TransistorTun/Tuna_Pedal/Digital_Multi_Effect_Guitar_Pedal_Spec.docx

# Thiết kế Pedal ghita kĩ thuật số đa hiệu ứng

DIGITAL MULTI EFFECT GUITAR PEDAL

# 1. Yêu cầu hệ thống

## 1.1. Tên hệ thống

- Tiếng Việt: Pedal kĩ thuật số đa hiệu ứng.
- Tiếng Anh:Digital Multi Effect Pedal.

## 1.2. Mục đích

- Thu gọn nhiều bộ pedal Analog thành một bộ pedal Digital.
- Tạo ra nhiều hiệu ứng hơn cho các loại nhạc cụ điện tử.

## 1.3. Đầu vào – đầu ra

### 1.3.1. Đầu vào

- Tín hiệu analog được thu từ ghita điện hoặc piano điện,…
- 2 Nút nhấn.
- 3 Rotery Encoder.
- 2 Switch.

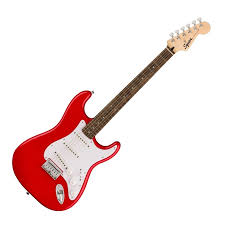
[picture p1: figure]
Đàn guitar điện Squier Sonic Stratocaster HT Torino Red

Hình 1-1.Nhạc cụ điện.

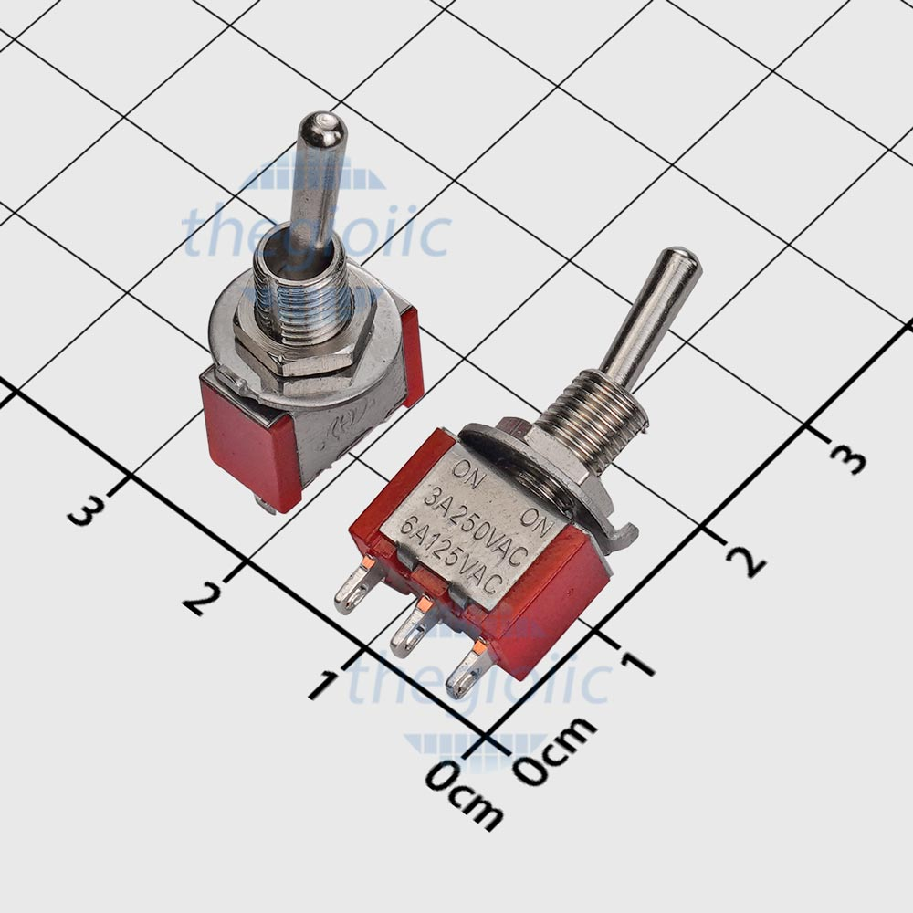
[picture p2: figure]

Hình 1-2. Switch gạt.

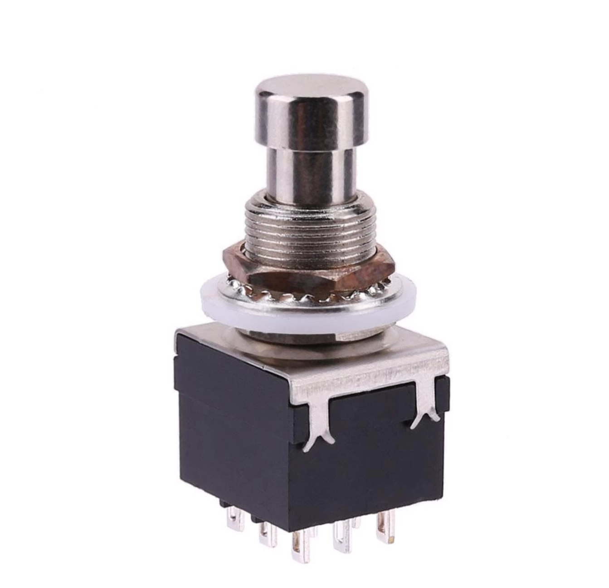
[picture p3: figure]

Hình 1-3. Nút nhấn đạp

### 1.3.2. Đầu ra

- Âm thanh đã được xử lý theo ý muốn.
- Màn hình giúp cho người sử dụng dễ dàng điều khiển và sử dụng.

## 1.4. Trường hợp sử dụng

- Sử dụng để tạo ra những hiệu ứng âm thanh tùy thuộc vào thể loại âm nhạc mà người sử dụng nhạc cụ đang chơi, tạo ra them nhiều màu sắc hơn cho âm thanh.

## 1.5. Chức năng

- Biến đổi, điều chỉnh và lọc nhiễu âm thanh như ý muốn của người sử dụng.

## 1.6. Hiệu năng

- Lấy mẫu: Có thể lấy mẫu từ khoảng 48 – 96 kHz.
- Output: Đưa ra được âm thanh chất lượng cao.
- Hiệu ứng: Được ít nhất từ 5 -10 hiệu ứng, có thể điều chỉnh được các thông số trên hiệu ứng đó.

## 1.7. Nguồn cấp

- Nguồn cấp lấy từ adapter 12V 2A.

## 1.8. Lắp đặt

## 1.9. Chi phí sản xuất

- Chi phí dự kiến cho mạch đo:
- Chi phí dự kiến cho điện cực:

# 2. Lựa chọn linh kiện

## 2.1. Input

Đầu nối từ nhạc cụ tới board ta sử dụng: PJ-309 Cổng Audio 6.35mm 3 Cực 3 Chân Hàn PCB Loại Mono, Size: 35 x 18 x 11mm (https://www.thegioiic.com/pj-309-cong-audio-6-35mm-3-cuc-3-chan-han-pcb)

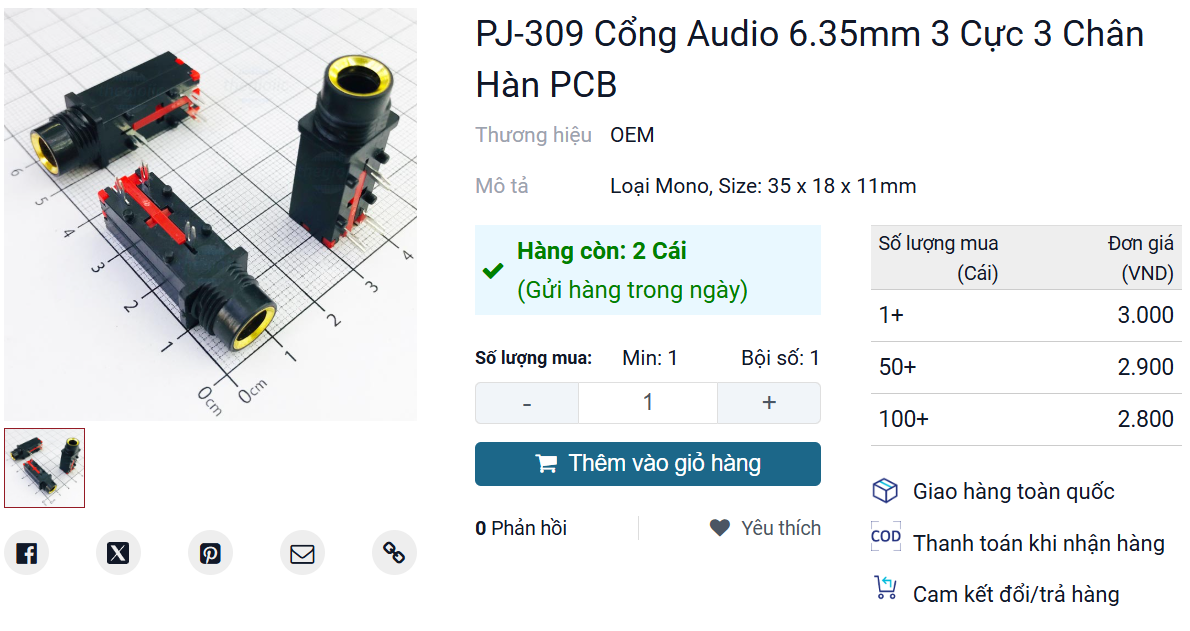
[picture p4: figure]

## 2.2. Buffer (Bộ đệm ngõ vào)

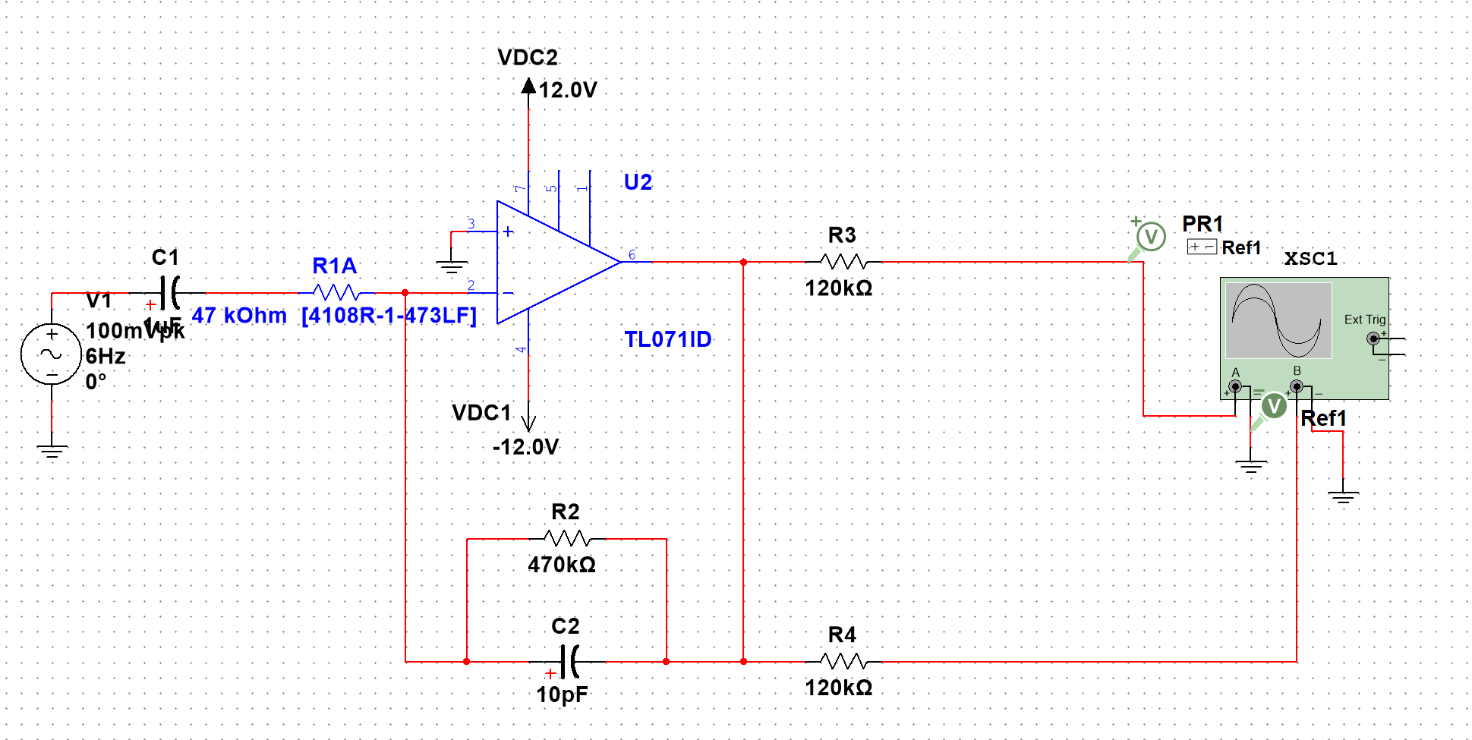
[picture p5: figure]

Lựa chọn: TL071

## 2.3. Audio Codec

Để hình có thể dễ dàng phân chia analog và digital một cách dễ dàng và thuận tiện thì sử dụng CS4270.

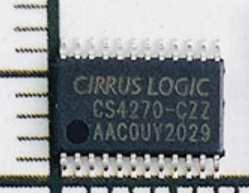
[picture p6: figure]

Chip này có thể dễ dàng mua ở Việt Nam: ::.CS4270 CS4270-CZZR TSSOP-24 chính hãng CIRRUS.:: (https://linhkienchatluong.vn/ic-audio/cs4270-cs4270-czzr-tssop-24-chinh-hang-cirrus_sp577_ct9328.aspx)

## 2.4. Khối xử lý - DSP

### 2.4.1. MCU

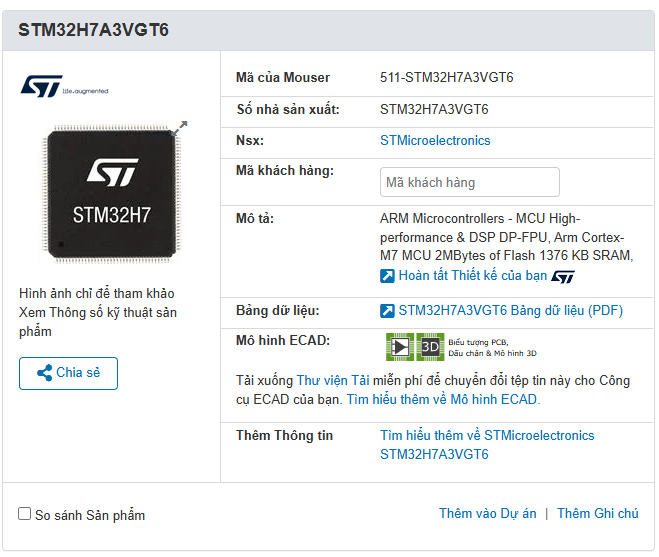
[picture p7: figure]

Lý do chọn:

- Có flash 2Mbytes: để điều khiển màn hình
- Có tốc độ xử lý cao 280MHz

Link: STM32H7A3VGT6 STMicroelectronics | Mouser Việt Nam (https://www.mouser.vn/ProductDetail/STMicroelectronics/STM32H7A3VGT6?qs=sPbYRqrBIVkRnX%252BMGuTgYg%3D%3D)

## 2.5. Màn hình

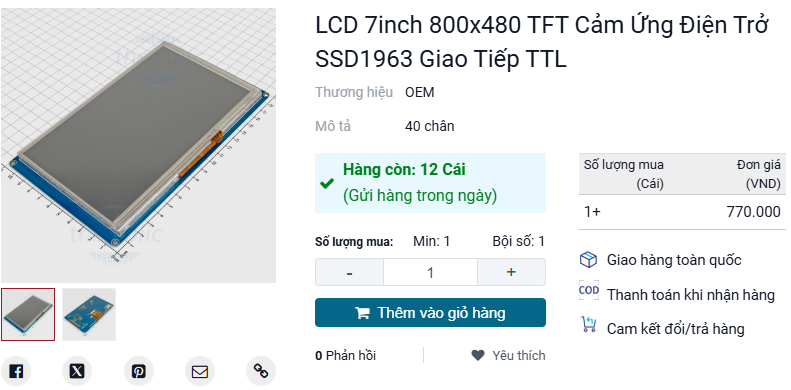
[picture p8: figure]

Link mua hàng: LCD 7inch 800x480 TFT Cảm Ứng Điện Trở SSD1963 Giao Tiếp TTL 40 chân (https://www.thegioiic.com/lcd-7inch-800x480-tft-cam-ung-dien-tro-ssd1963-giao-tiep-ttl)

- Vẽ board màn hình luôn !

## 2.6. Khối nút nhấn và encoder

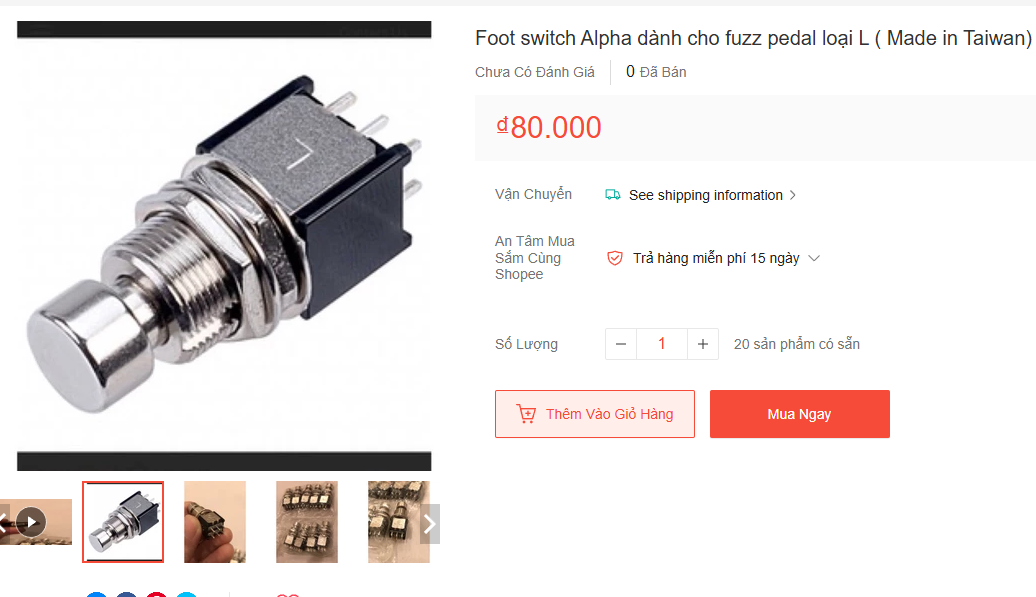
[picture p9: figure]
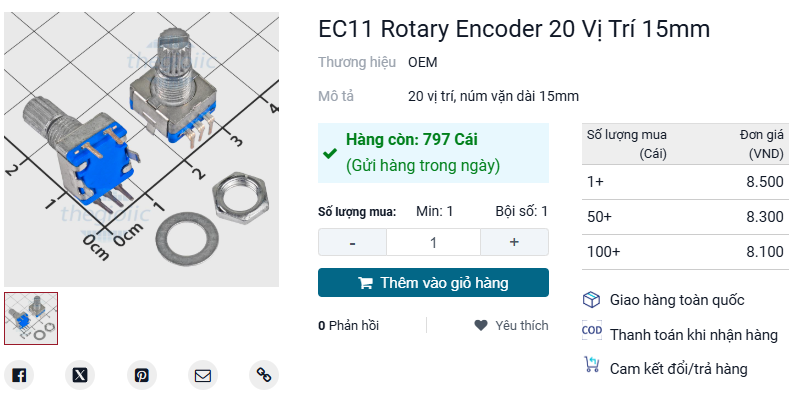
[picture p10: figure]

## 2.7. Khối nguồn
