TransistorTun/Tuna_Pedal/Hardware/ver1/Tuna_Pedal_ver1.0.pdf

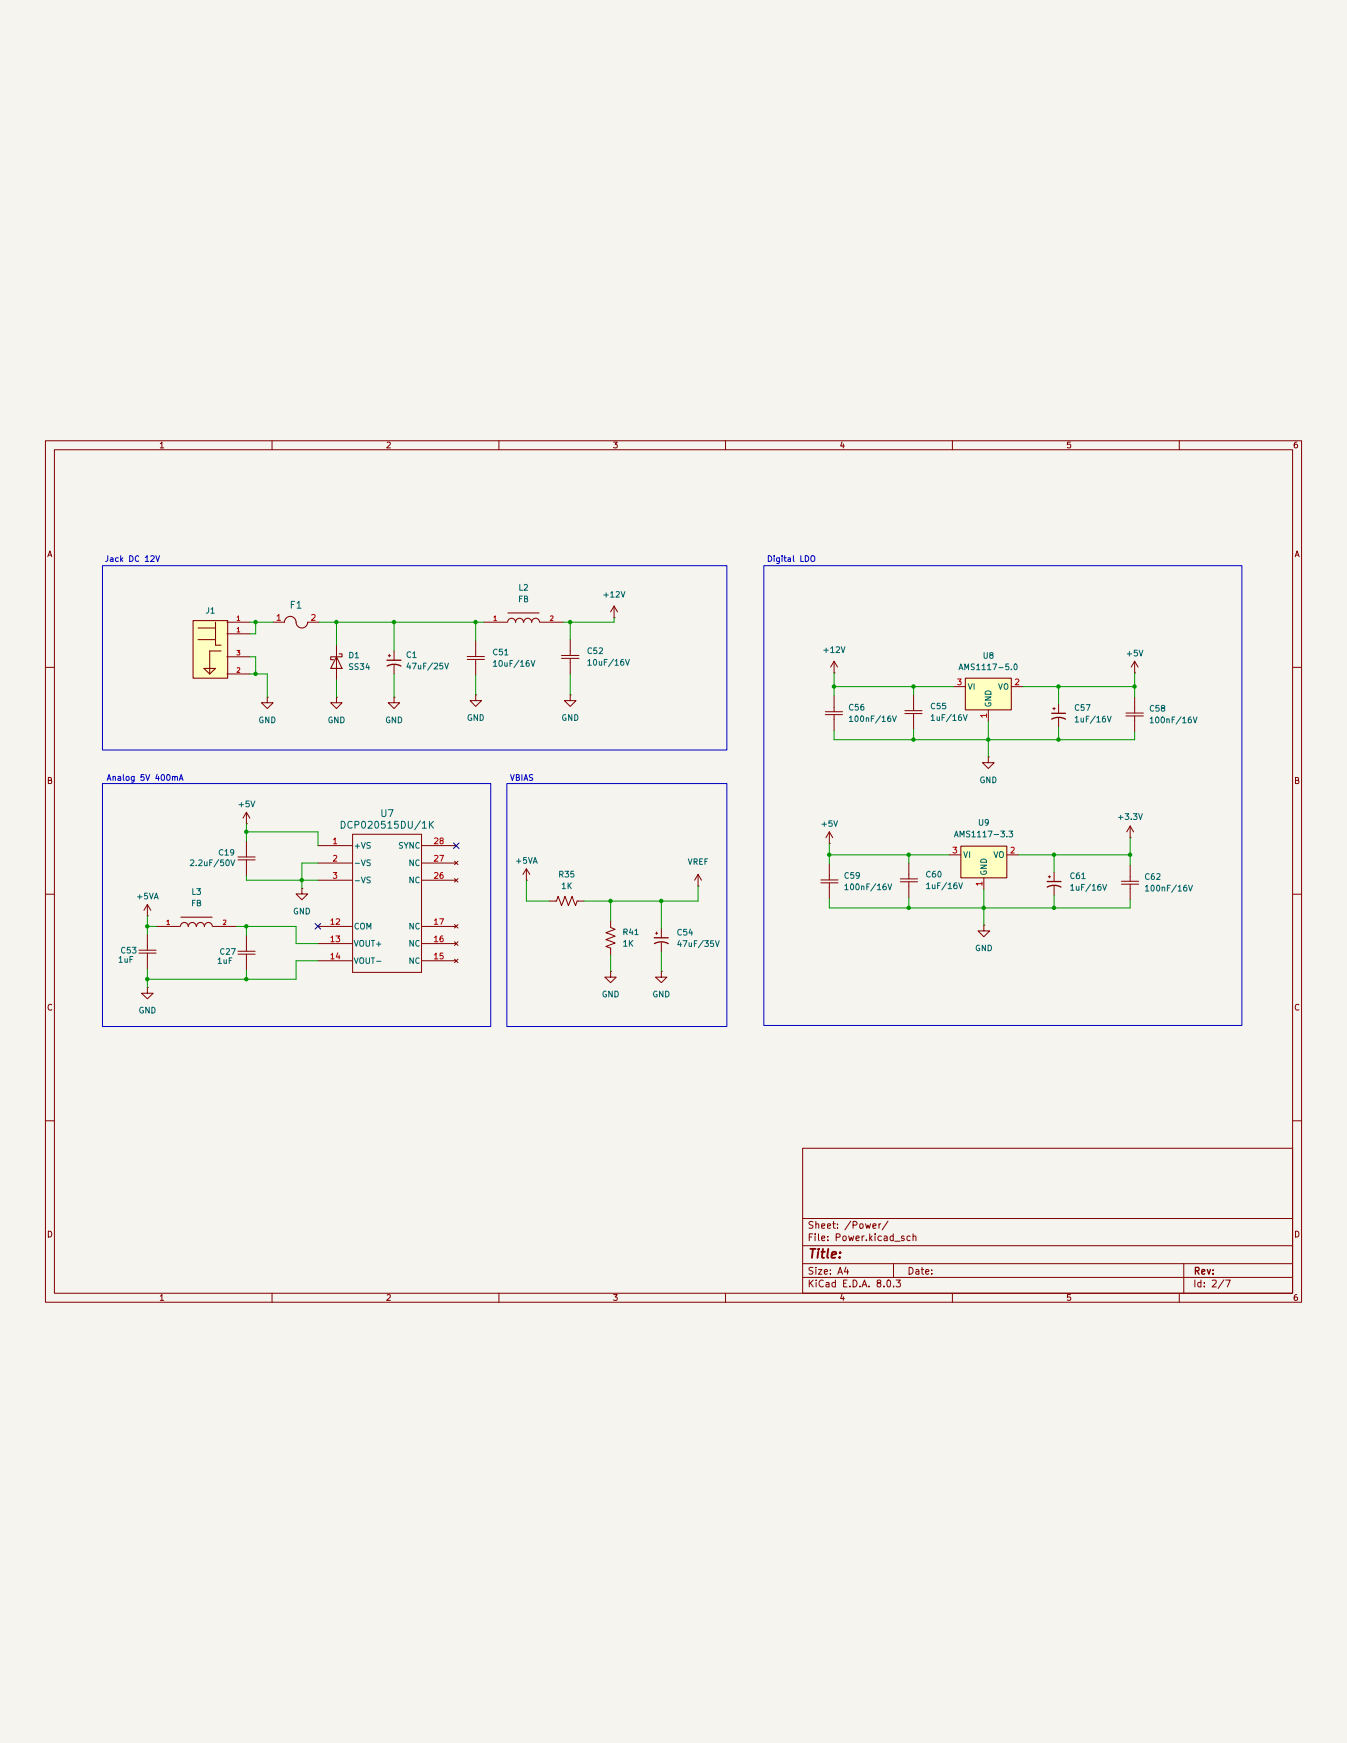
[picture p20: page 2]

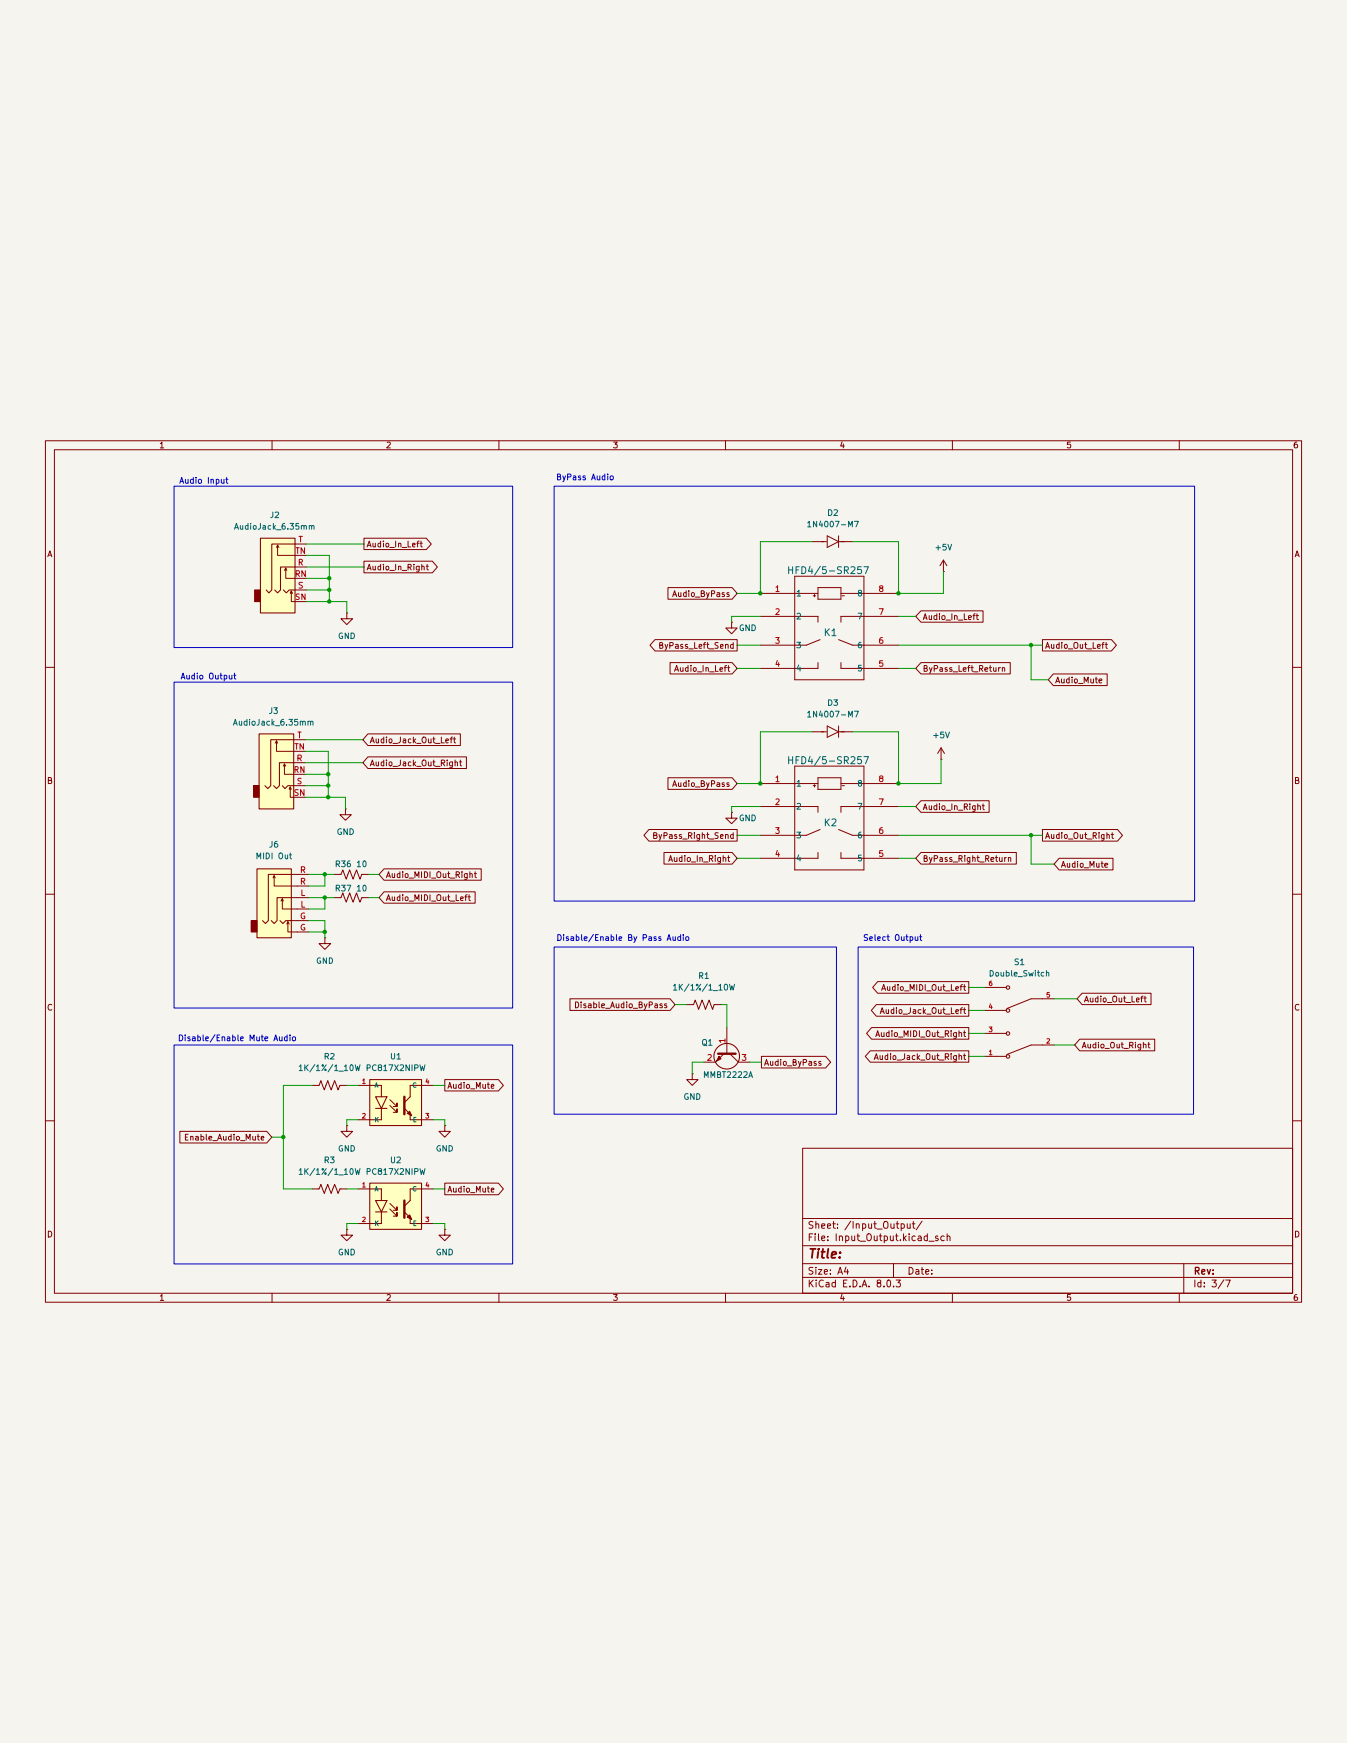
[picture p21: page 3]

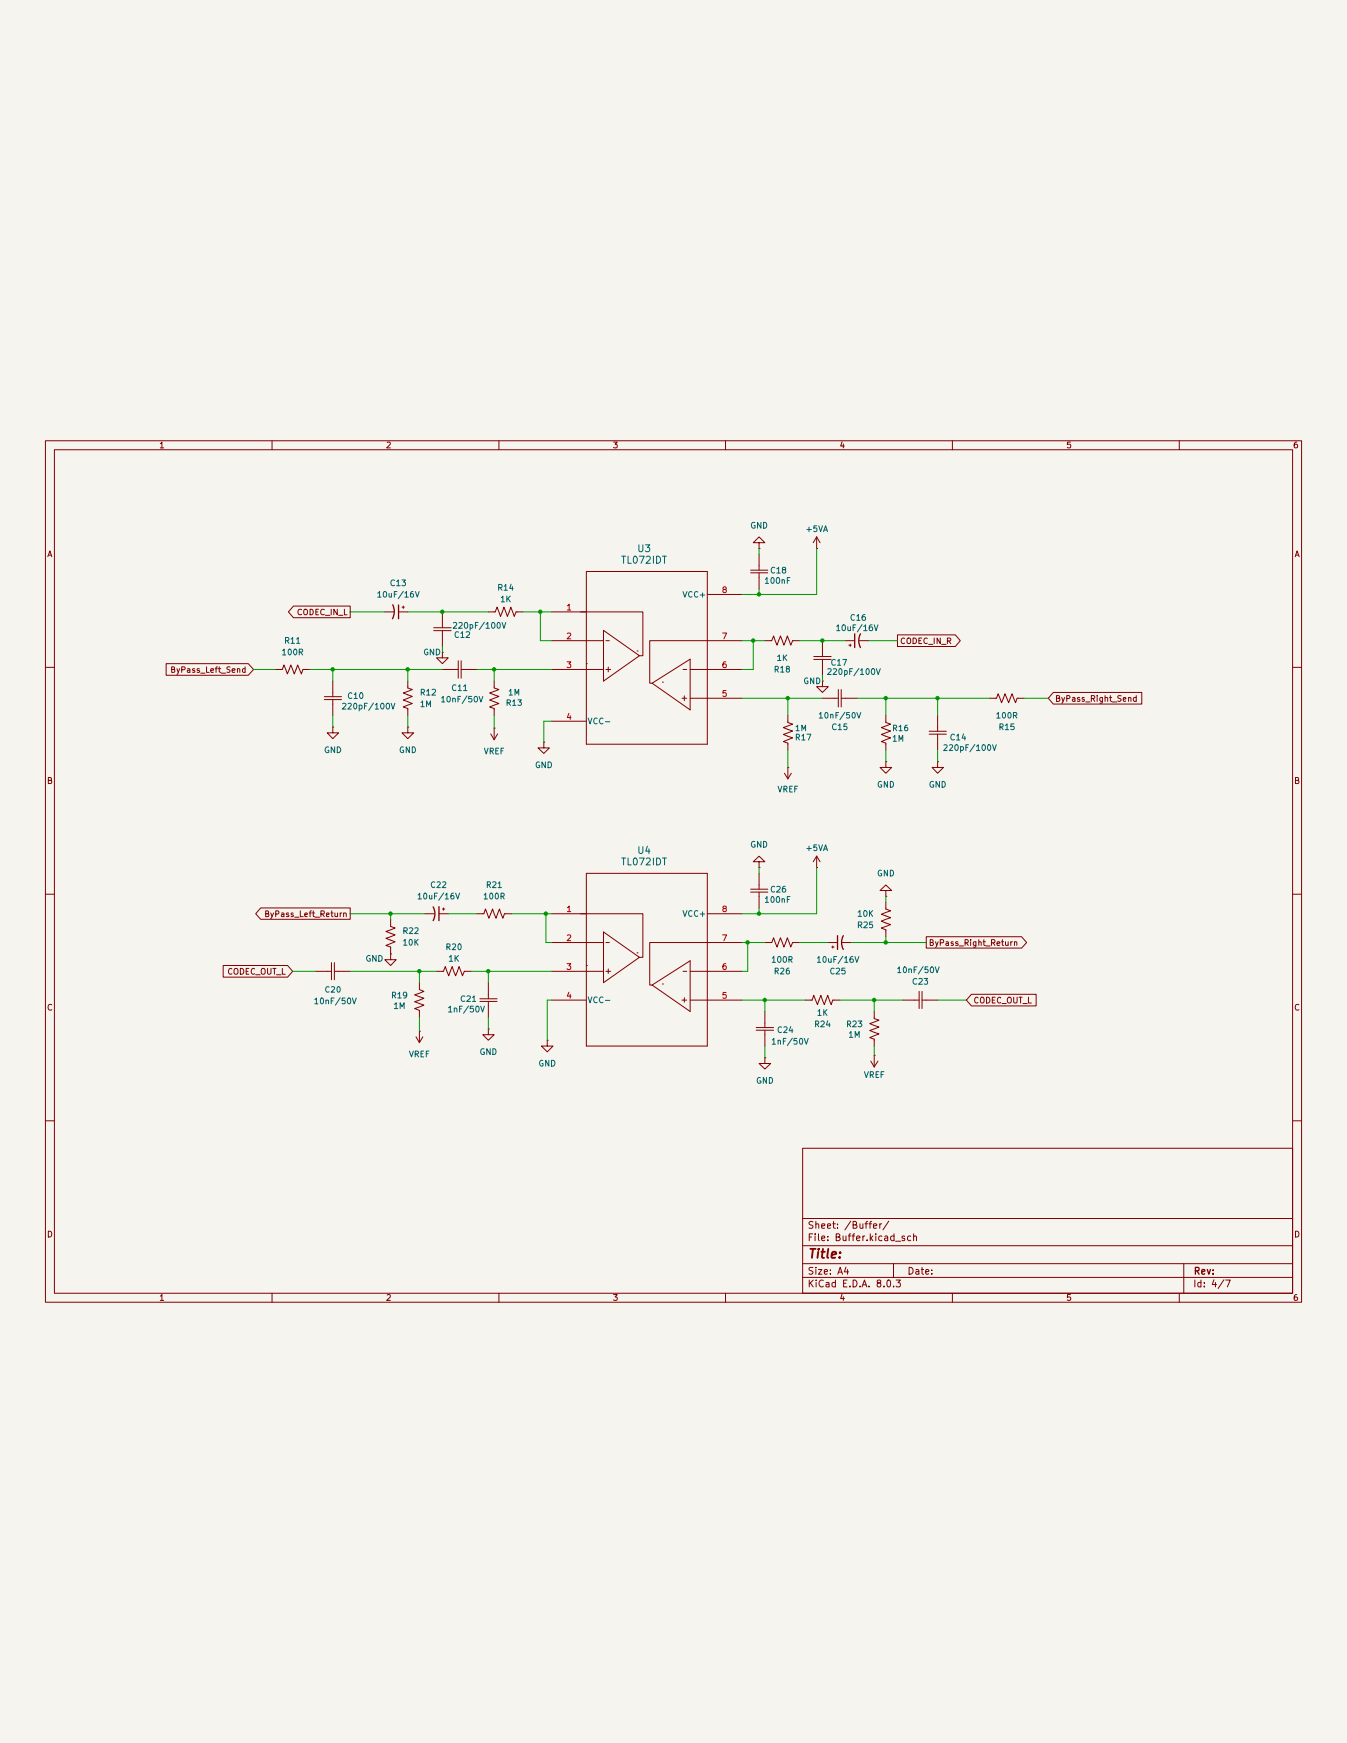
[picture p22: page 4]

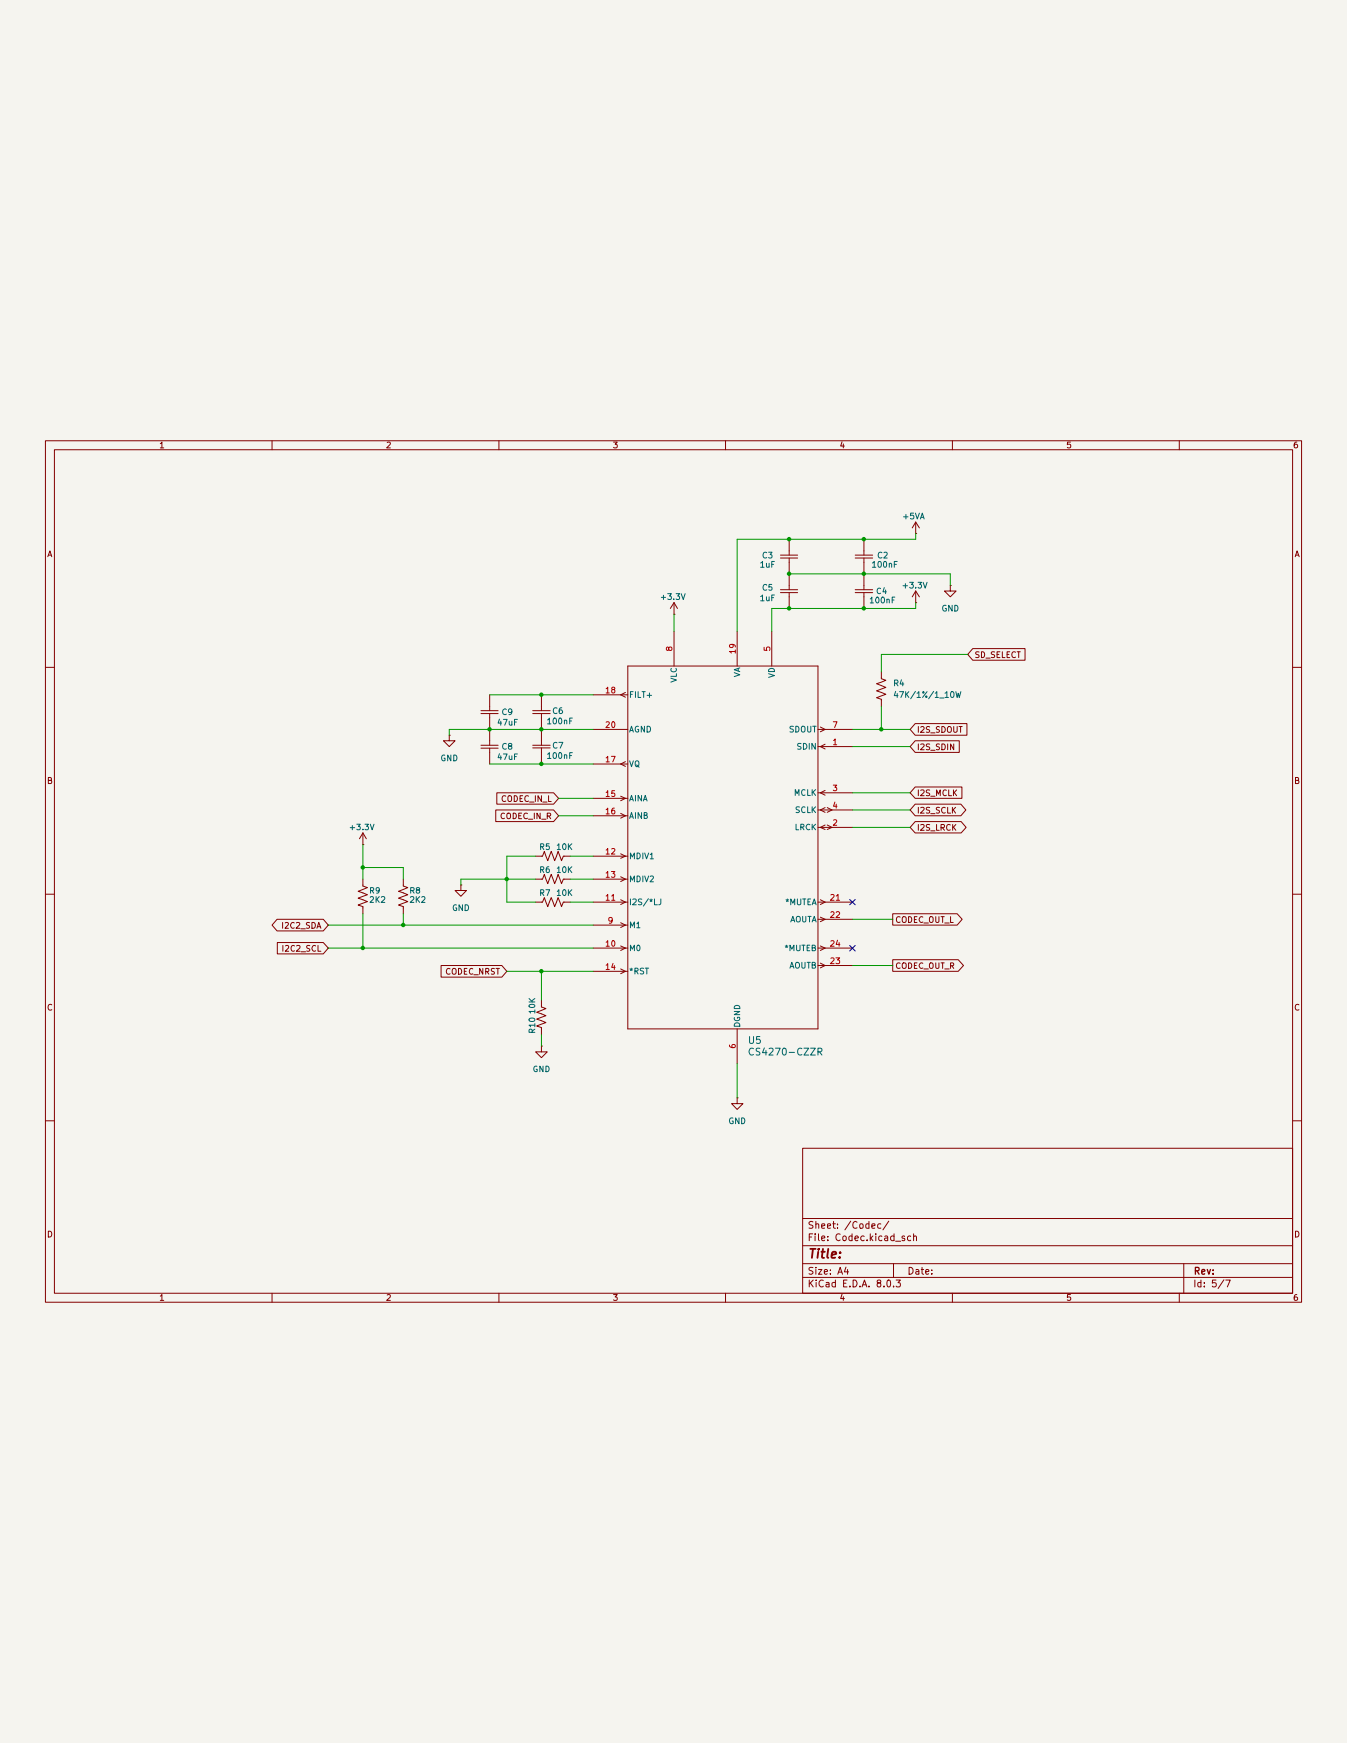
[picture p23: page 5]

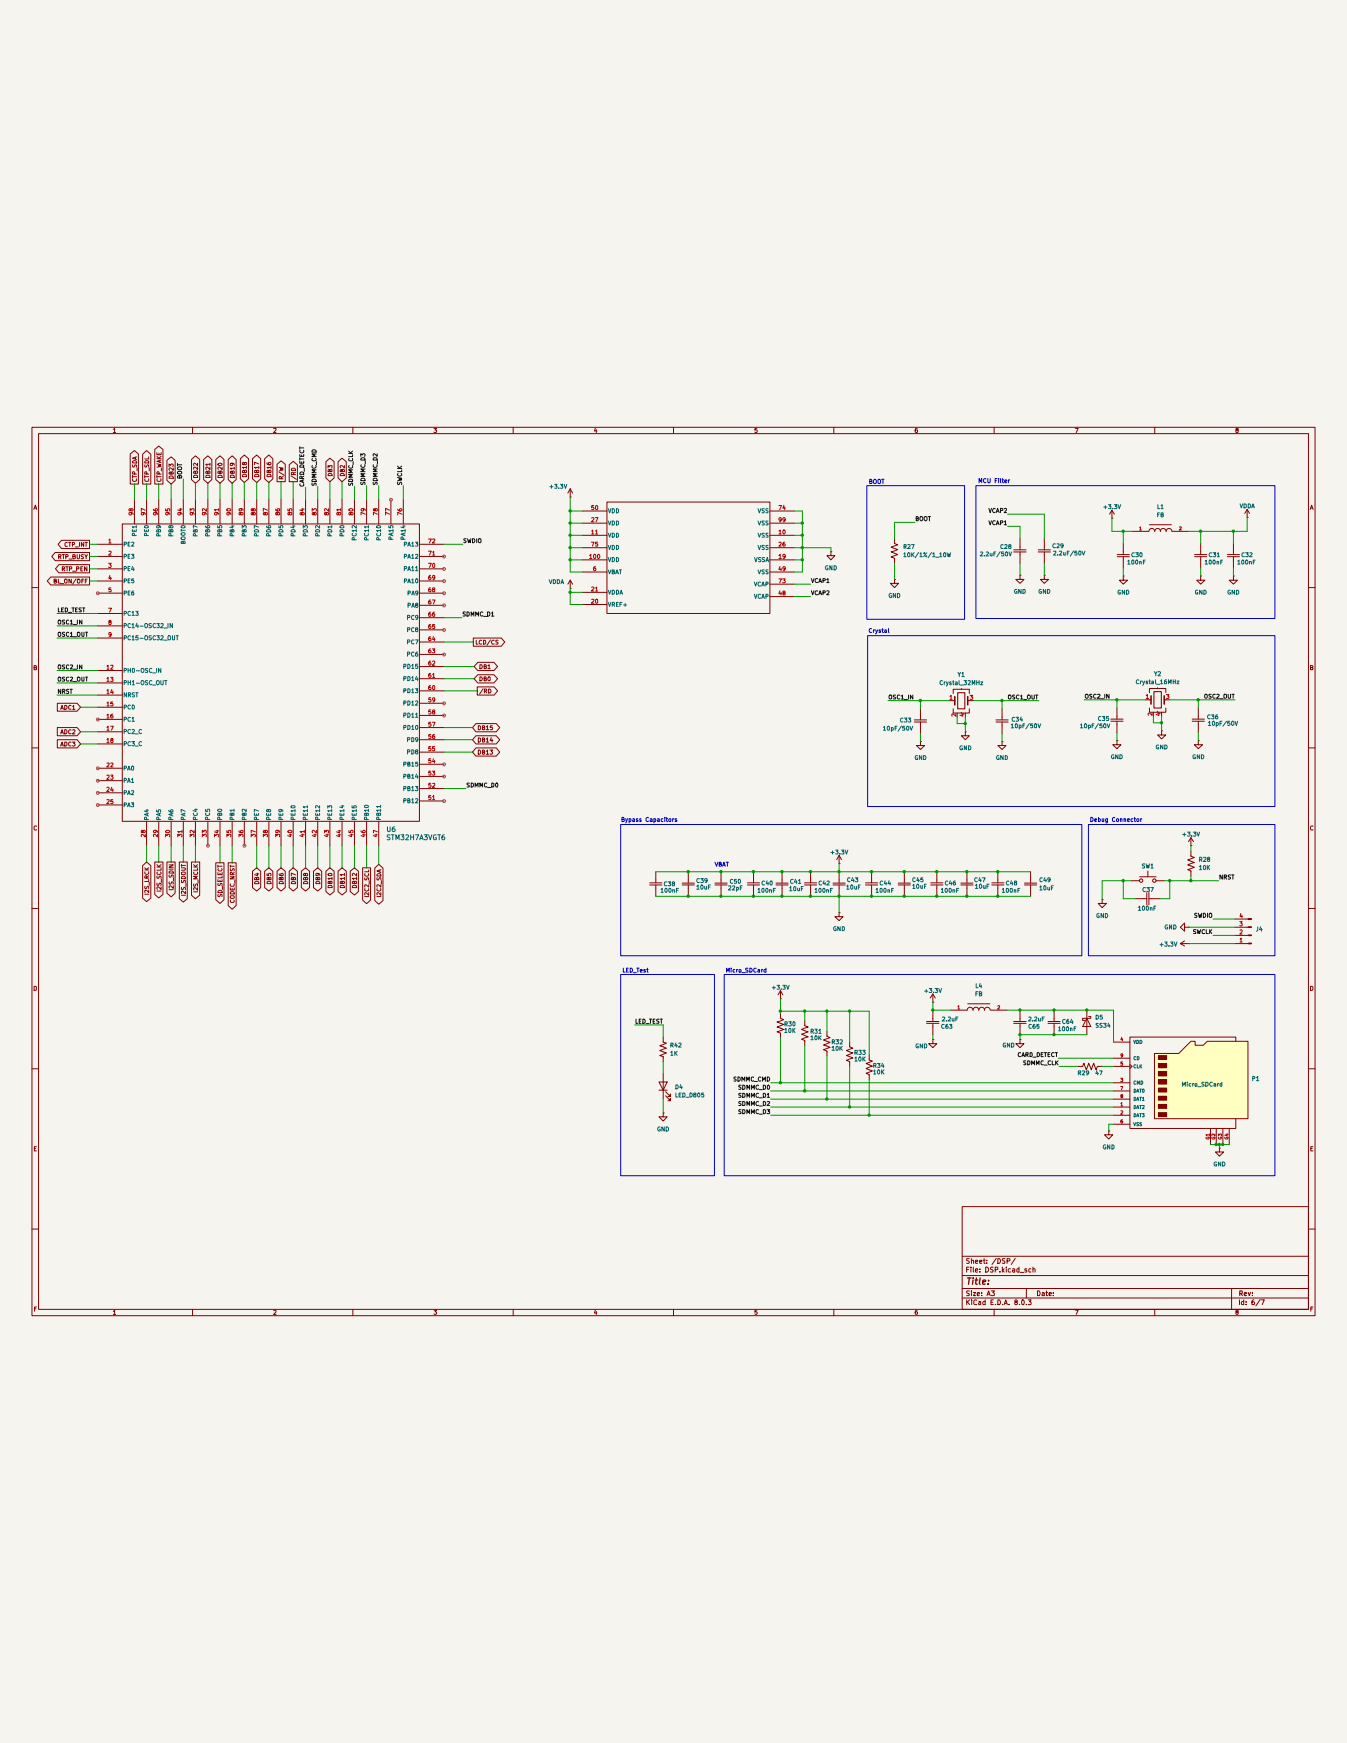
[picture p24: page 6]

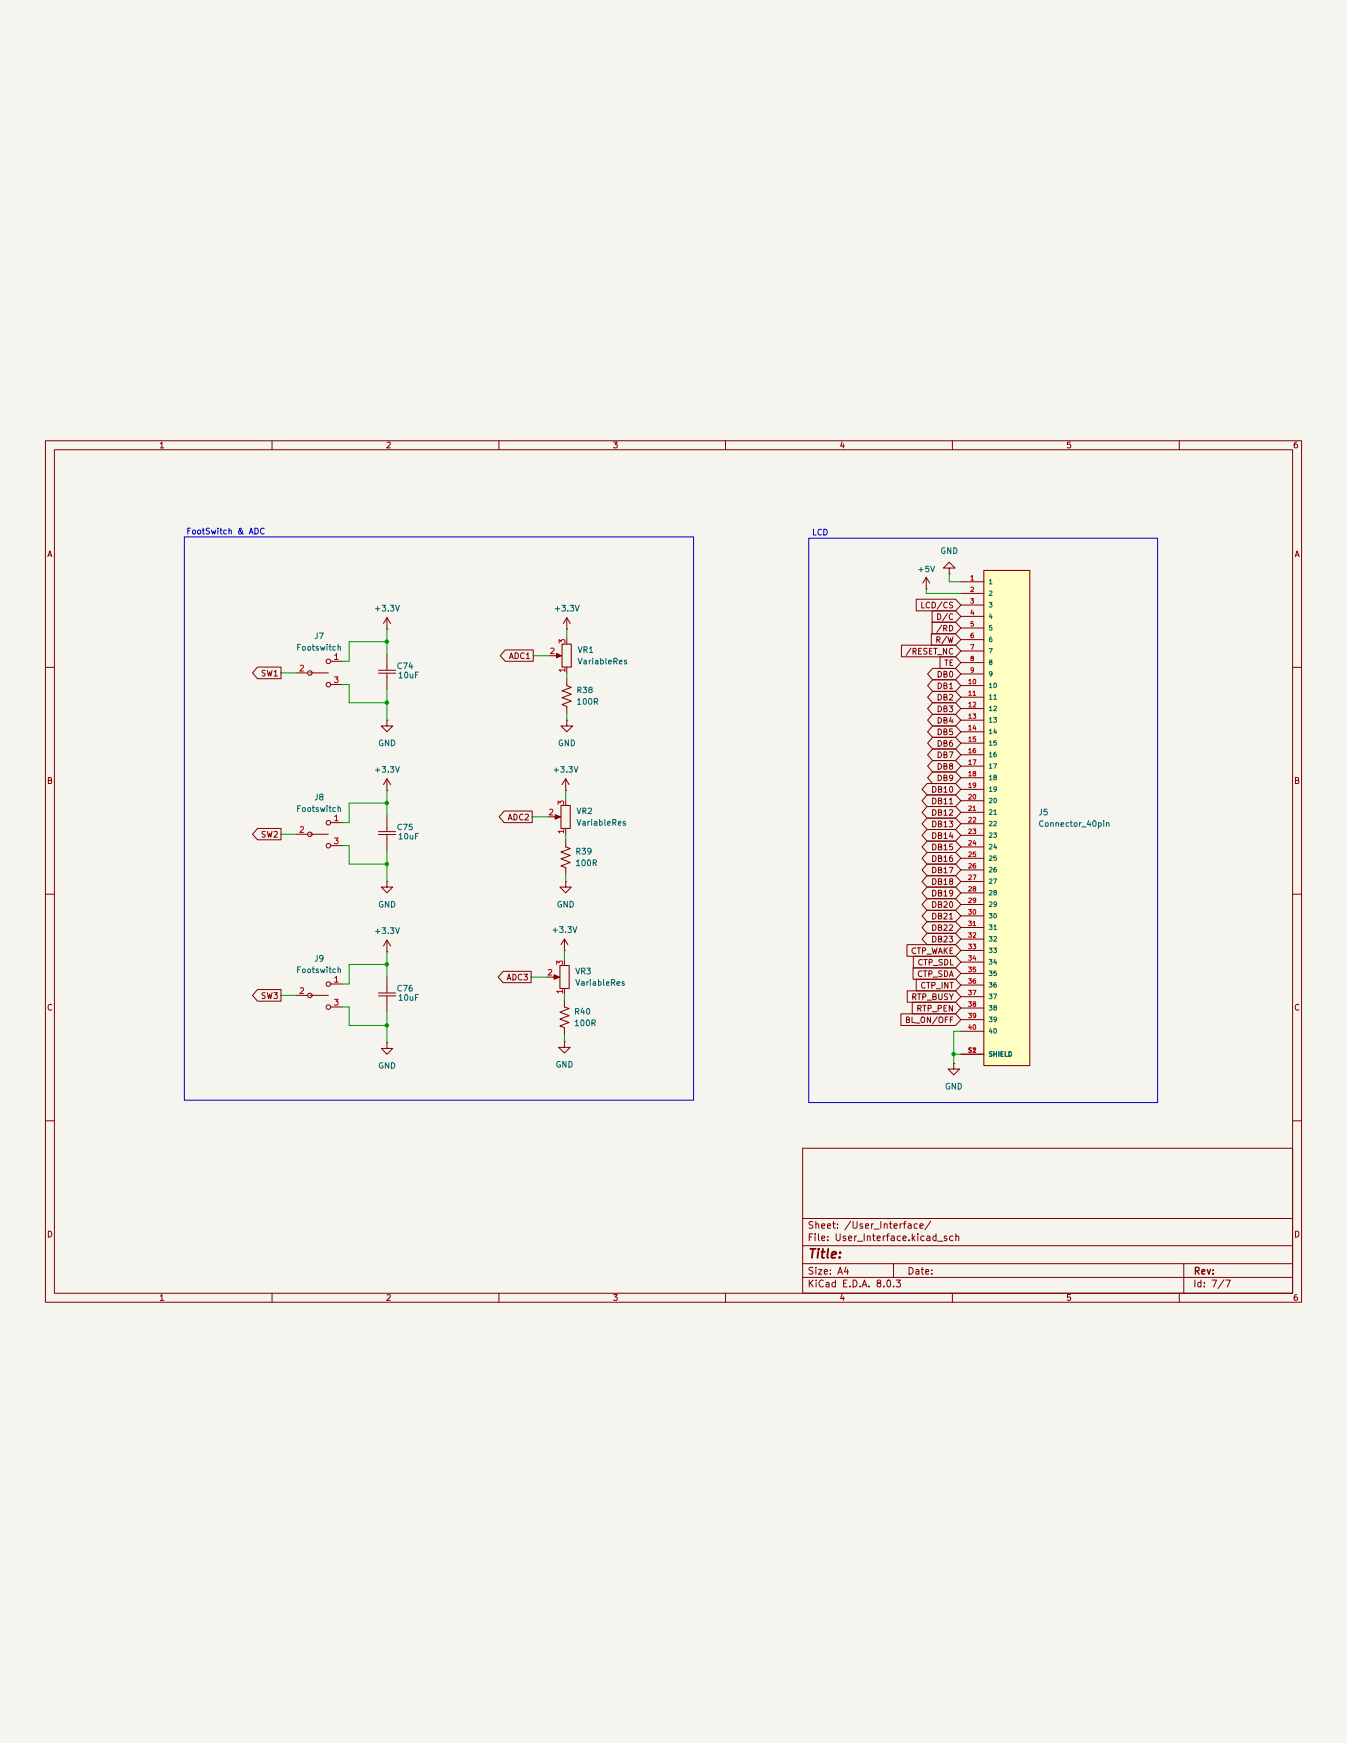
[picture p25: page 7]
