TransistorTun/Tuna_Pedal/(list of files, drawings)

Other design files:
Hardware/ver1/Logo/PIF/Logo_PIF.PcbLib
