TransistorTun/Tuna_Pedal/Hardware/ver1/Digital_Multi_Pedal_v1/Digital_Multi_Pedal_v1.kicad_pcb

## KiCad design Hardware/ver1/Digital_Multi_Pedal_v1/Digital_Multi_Pedal_v1.kicad_pcb (2025-02-17)

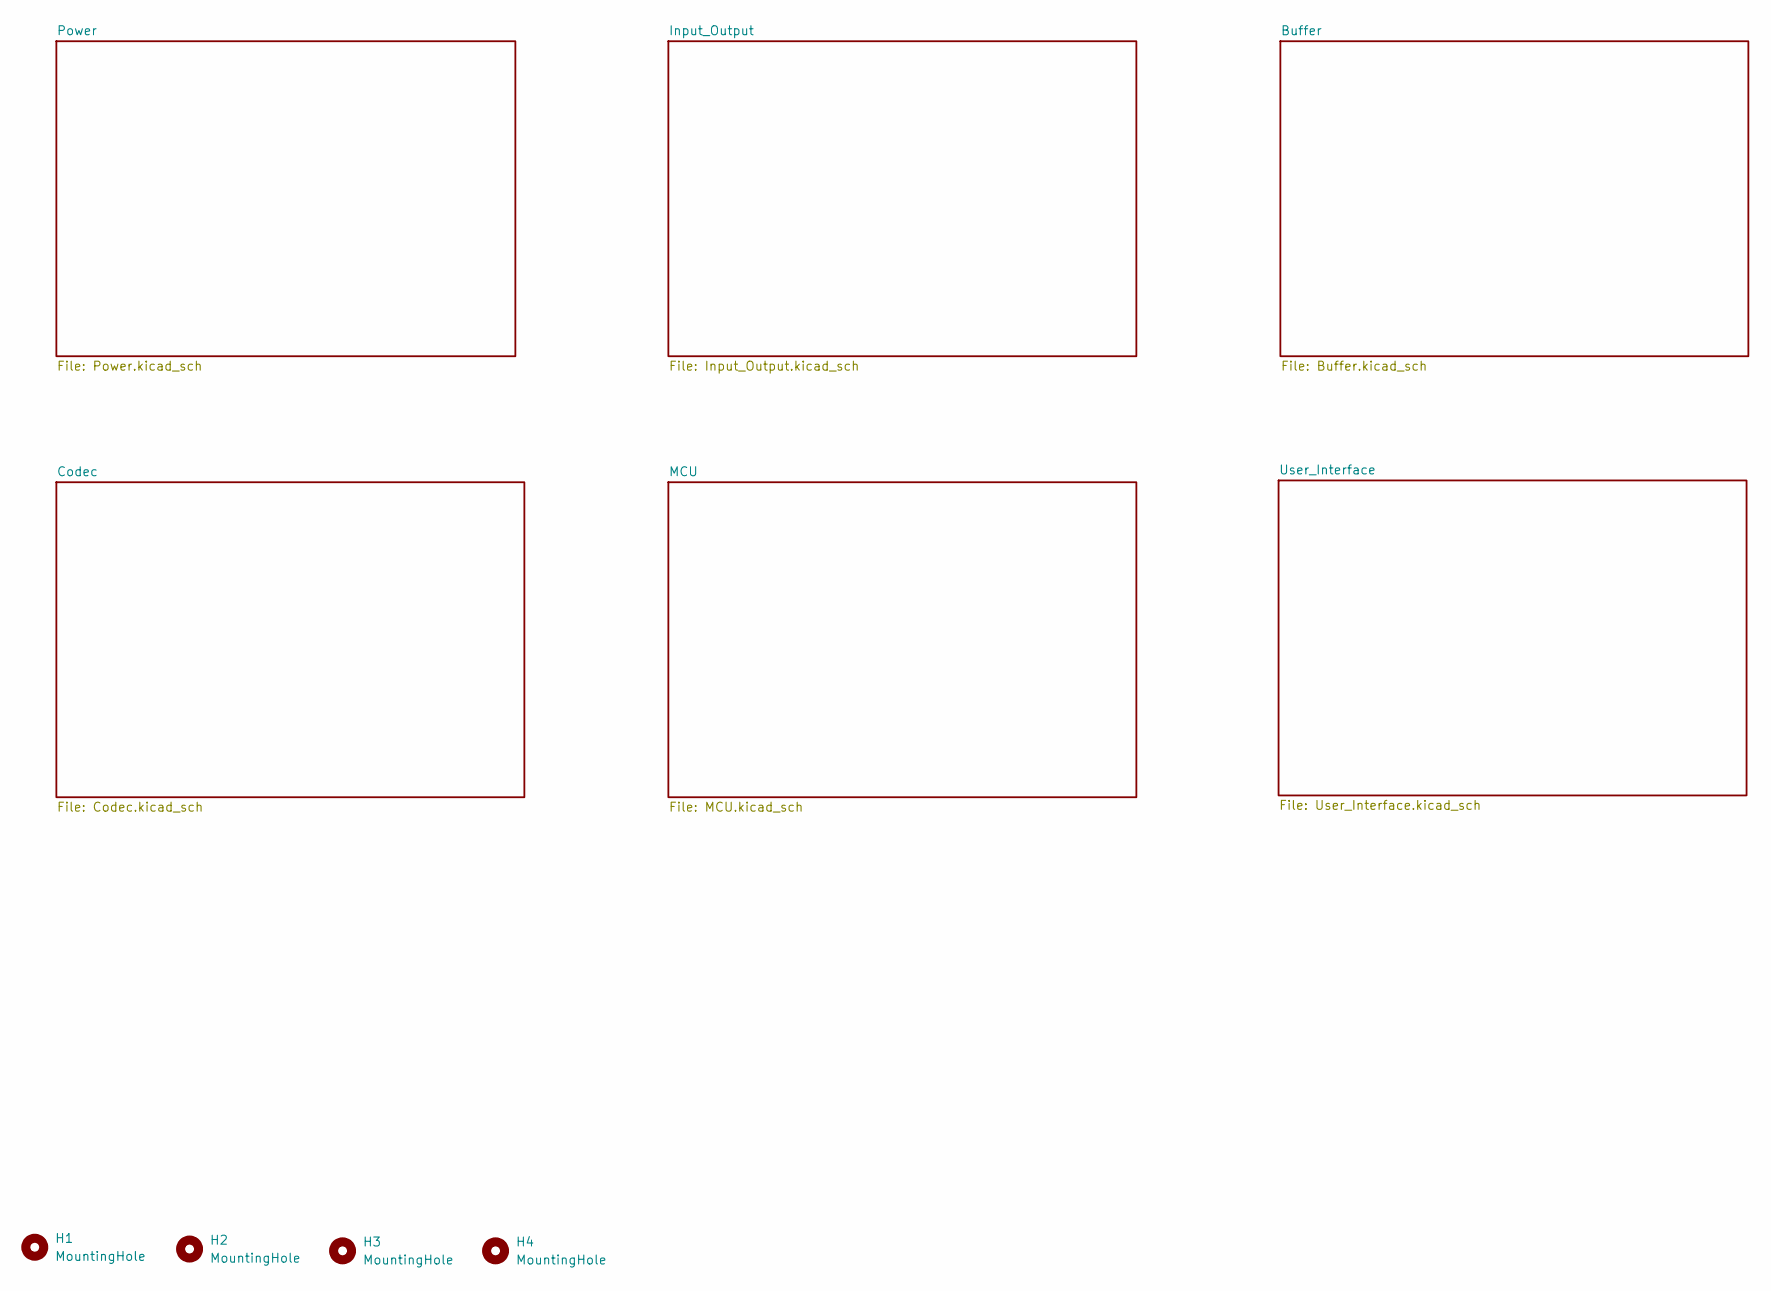
[picture p26: schematic Digital_Multi_Pedal_v1.kicad_sch]

Parts:
H1, H2, H3, H4: MountingHole; MountingHole_3.2mm_M3_Pad_Via

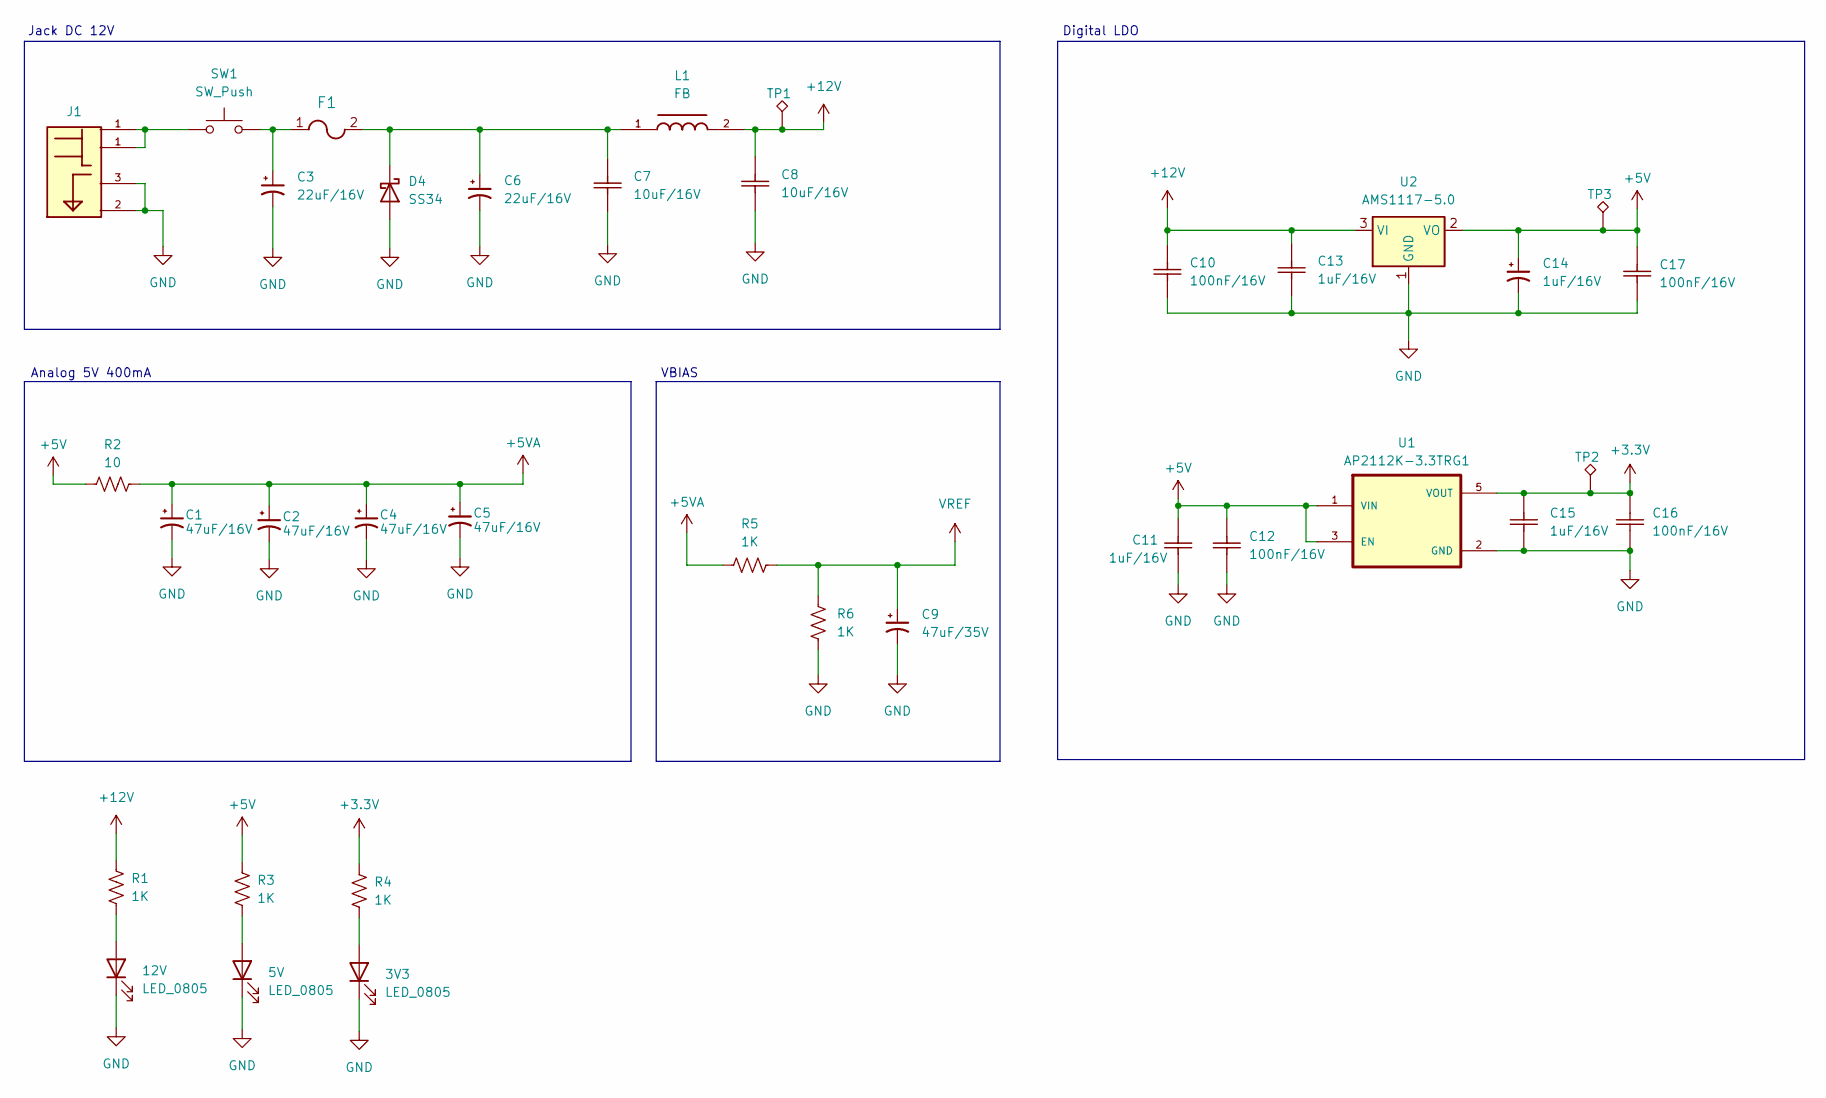
[picture p27: schematic Power.kicad_sch]

Parts:
3V3, 5V, 12V: LED_0805
C1, C2, C4, C5: 47uF/16V; Tan_Cap_C
C3, C6: 22uF/16V; Tan_Cap_A
C7, C8: 10uF/16V; Ceramic_Cap_0603
C9: 47uF/35V; Tan_Cap_C
C10, C12, C16, C17: 100nF/16V; Ceramic_Cap_0603
C11, C13, C15: 1uF/16V; Ceramic_Cap_0603
C14: 1uF/16V; Tan_Cap_A
D4: SS34; D_SMA
F1: Fuse; FUSE_1812L_LTF
J1: DCJ200-05-A-XX-X_REVA; JackDC
L1: FB; FB_0805
R1, R3, R4, R5, R6: 1K; Res_0603
R2: 10; Res_0603
SW1: SW_Push; Header_PW_Switch
TP1, TP2, TP3: TestPoint_Alt; TestPoint_Pad_D1.5mm
U1: AP2112K-3.3TRG1; SOT23; PARTREV 2-2
U2: AMS1117-5.0; SOT-223-3_TabPin2

Connections:
+3.3V: C15.2, C16.2, R4.1, TP2.1, U1.5 (VOUT); also elsewhere on the board
+5V: C11.2, C12.2, C14.1, C17.2, R2.2, R3.1, TP3.1, U1.1 (VIN), U1.3 (EN), U2.2 (VO); also elsewhere on the board
+5VA: C1.1, C2.1, C4.1, C5.1, R2.1, R5.2; also elsewhere on the board
+12V: C8.2, C10.2, C13.2, L1.2, R1.1, TP1.1, U2.3 (VI)
GND: 3V3.1 (K), 5V.1 (K), 12V.1 (K), C1.2, C2.2, C3.2, C4.2, C5.2, C6.2, C7.1, C8.1, C9.2, C10.1, C11.1, C12.1, C13.1, C14.2, C15.1, C16.1, C17.1, D4.2 (A), J1.2, J1.3, R6.1, U1.2 (GND), U2.1 (GND); also elsewhere on the board
unnamed: C3.1, F1.1, SW1.2
unnamed: 12V.2 (A), R1.2
unnamed: 5V.2 (A), R3.2
unnamed: 3V3.2 (A), R4.2
unnamed: C6.1, C7.2, D4.1 (K), F1.2, L1.1
unnamed: J1.1, SW1.1
VREF: C9.1, R5.1, R6.2; also elsewhere on the board

Notes on the sheet:
VBIAS
Jack DC 12V
Analog 5V 400mA
Digital LDO

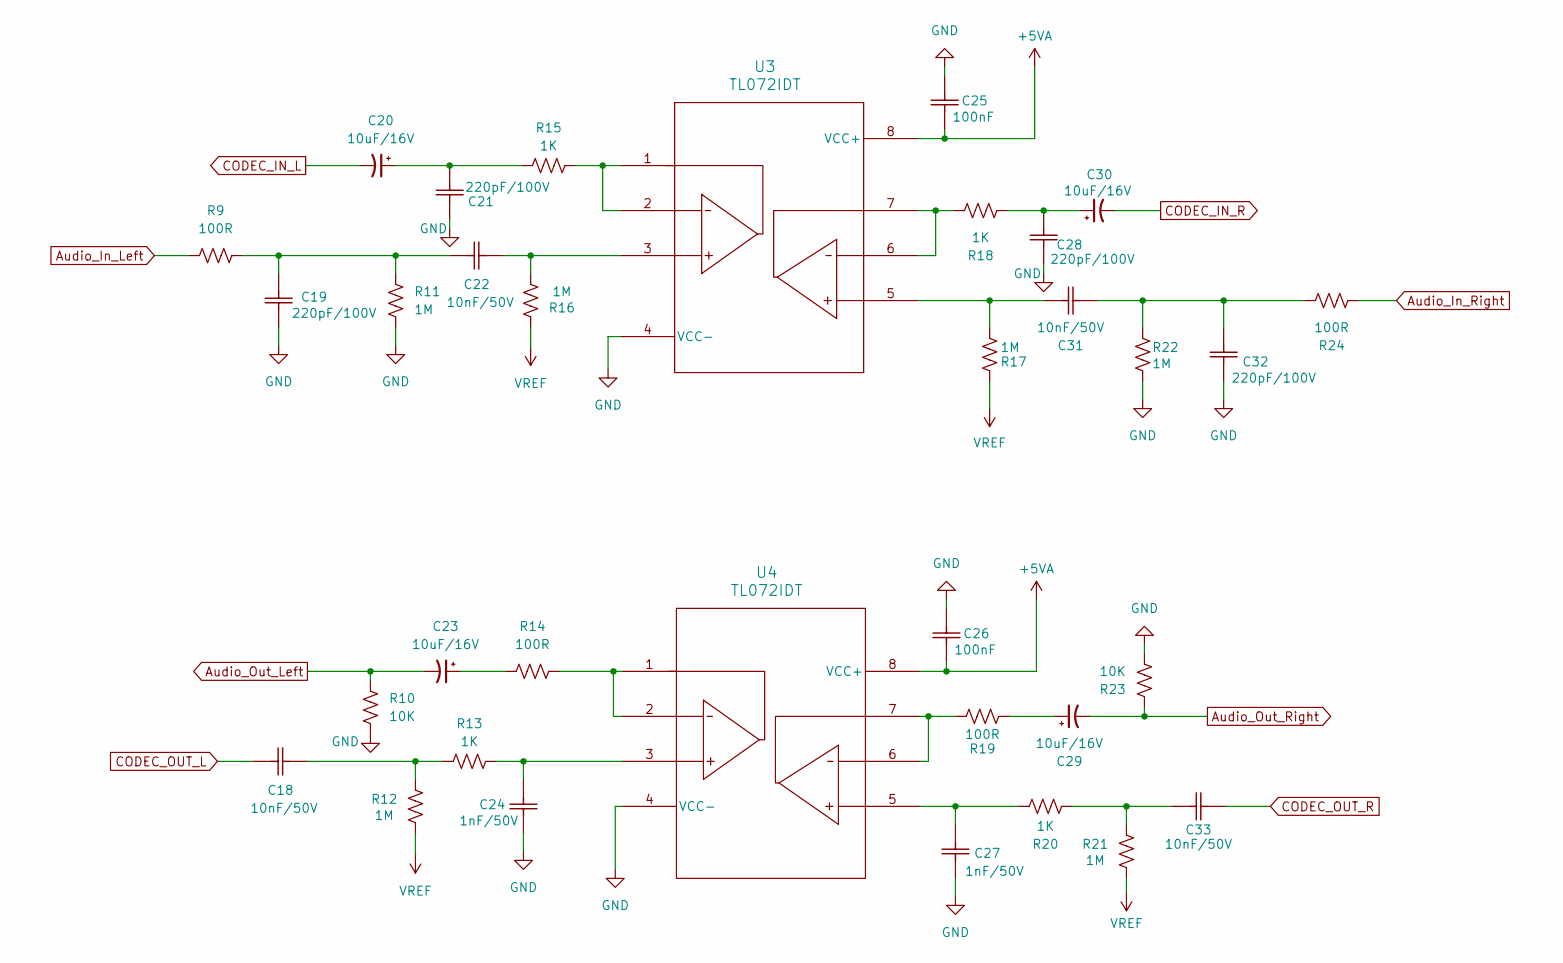
[picture p28: schematic Buffer.kicad_sch]

Parts:
C18, C22, C31, C33: 10nF/50V; Ceramic_Cap_0603
C19, C21, C28, C32: 220pF/100V; Ceramic_Cap_0603
C20, C23, C29, C30: 10uF/16V; Tan_Cap_A
C24, C27: 1nF/50V; Ceramic_Cap_0603
C25, C26: 100nF; Ceramic_Cap_0603
R9, R14, R19, R24: 100R; Res_0603
R10, R23: 10K; Res_0603
R11, R12, R16, R17, R21, R22: 1M; Res_0603
R13, R15, R18, R20: 1K; Res_0603
U3, U4: TL072IDT; D8_STM

Connections:
+5VA: C25.2, C26.2, U3.8 (VCC+), U4.8 (VCC+); also elsewhere on the board
Audio_In_Left: R9.1; also elsewhere on the board
Audio_In_Right: R24.1; also elsewhere on the board
Audio_Out_Left: C23.2, R10.2; also elsewhere on the board
Audio_Out_Right: C29.2, R23.2; also elsewhere on the board
CODEC_IN_L: C20.2; also elsewhere on the board
CODEC_IN_R: C30.2; also elsewhere on the board
CODEC_OUT_L: C18.1; also elsewhere on the board
CODEC_OUT_R: C33.1; also elsewhere on the board
GND: C19.2, C21.2, C24.1, C25.1, C26.1, C27.1, C28.2, C32.2, R10.1, R11.1, R22.1, R23.1, U3.4 (VCC-), U4.4 (VCC-); also elsewhere on the board
unnamed: C18.2, R12.2, R13.1
unnamed: C19.1, C22.1, R9.2, R11.2
unnamed: C20.1, C21.1, R15.1
unnamed: C22.2, R16.1, U3.3
unnamed: C23.1, R14.1
unnamed: C24.2, R13.2, U4.3
unnamed: C27.2, R20.2, U4.5
unnamed: C28.1, C30.1, R18.1
unnamed: C29.1, R19.1
unnamed: C31.1, C32.1, R22.2, R24.2
unnamed: C31.2, R17.1, U3.5
unnamed: C33.2, R20.1, R21.2
unnamed: R14.2, U4.1, U4.2
unnamed: R15.2, U3.1, U3.2
unnamed: R18.2, U3.6, U3.7
unnamed: R19.2, U4.6, U4.7
VREF: R12.1, R16.2, R17.2, R21.1; also elsewhere on the board

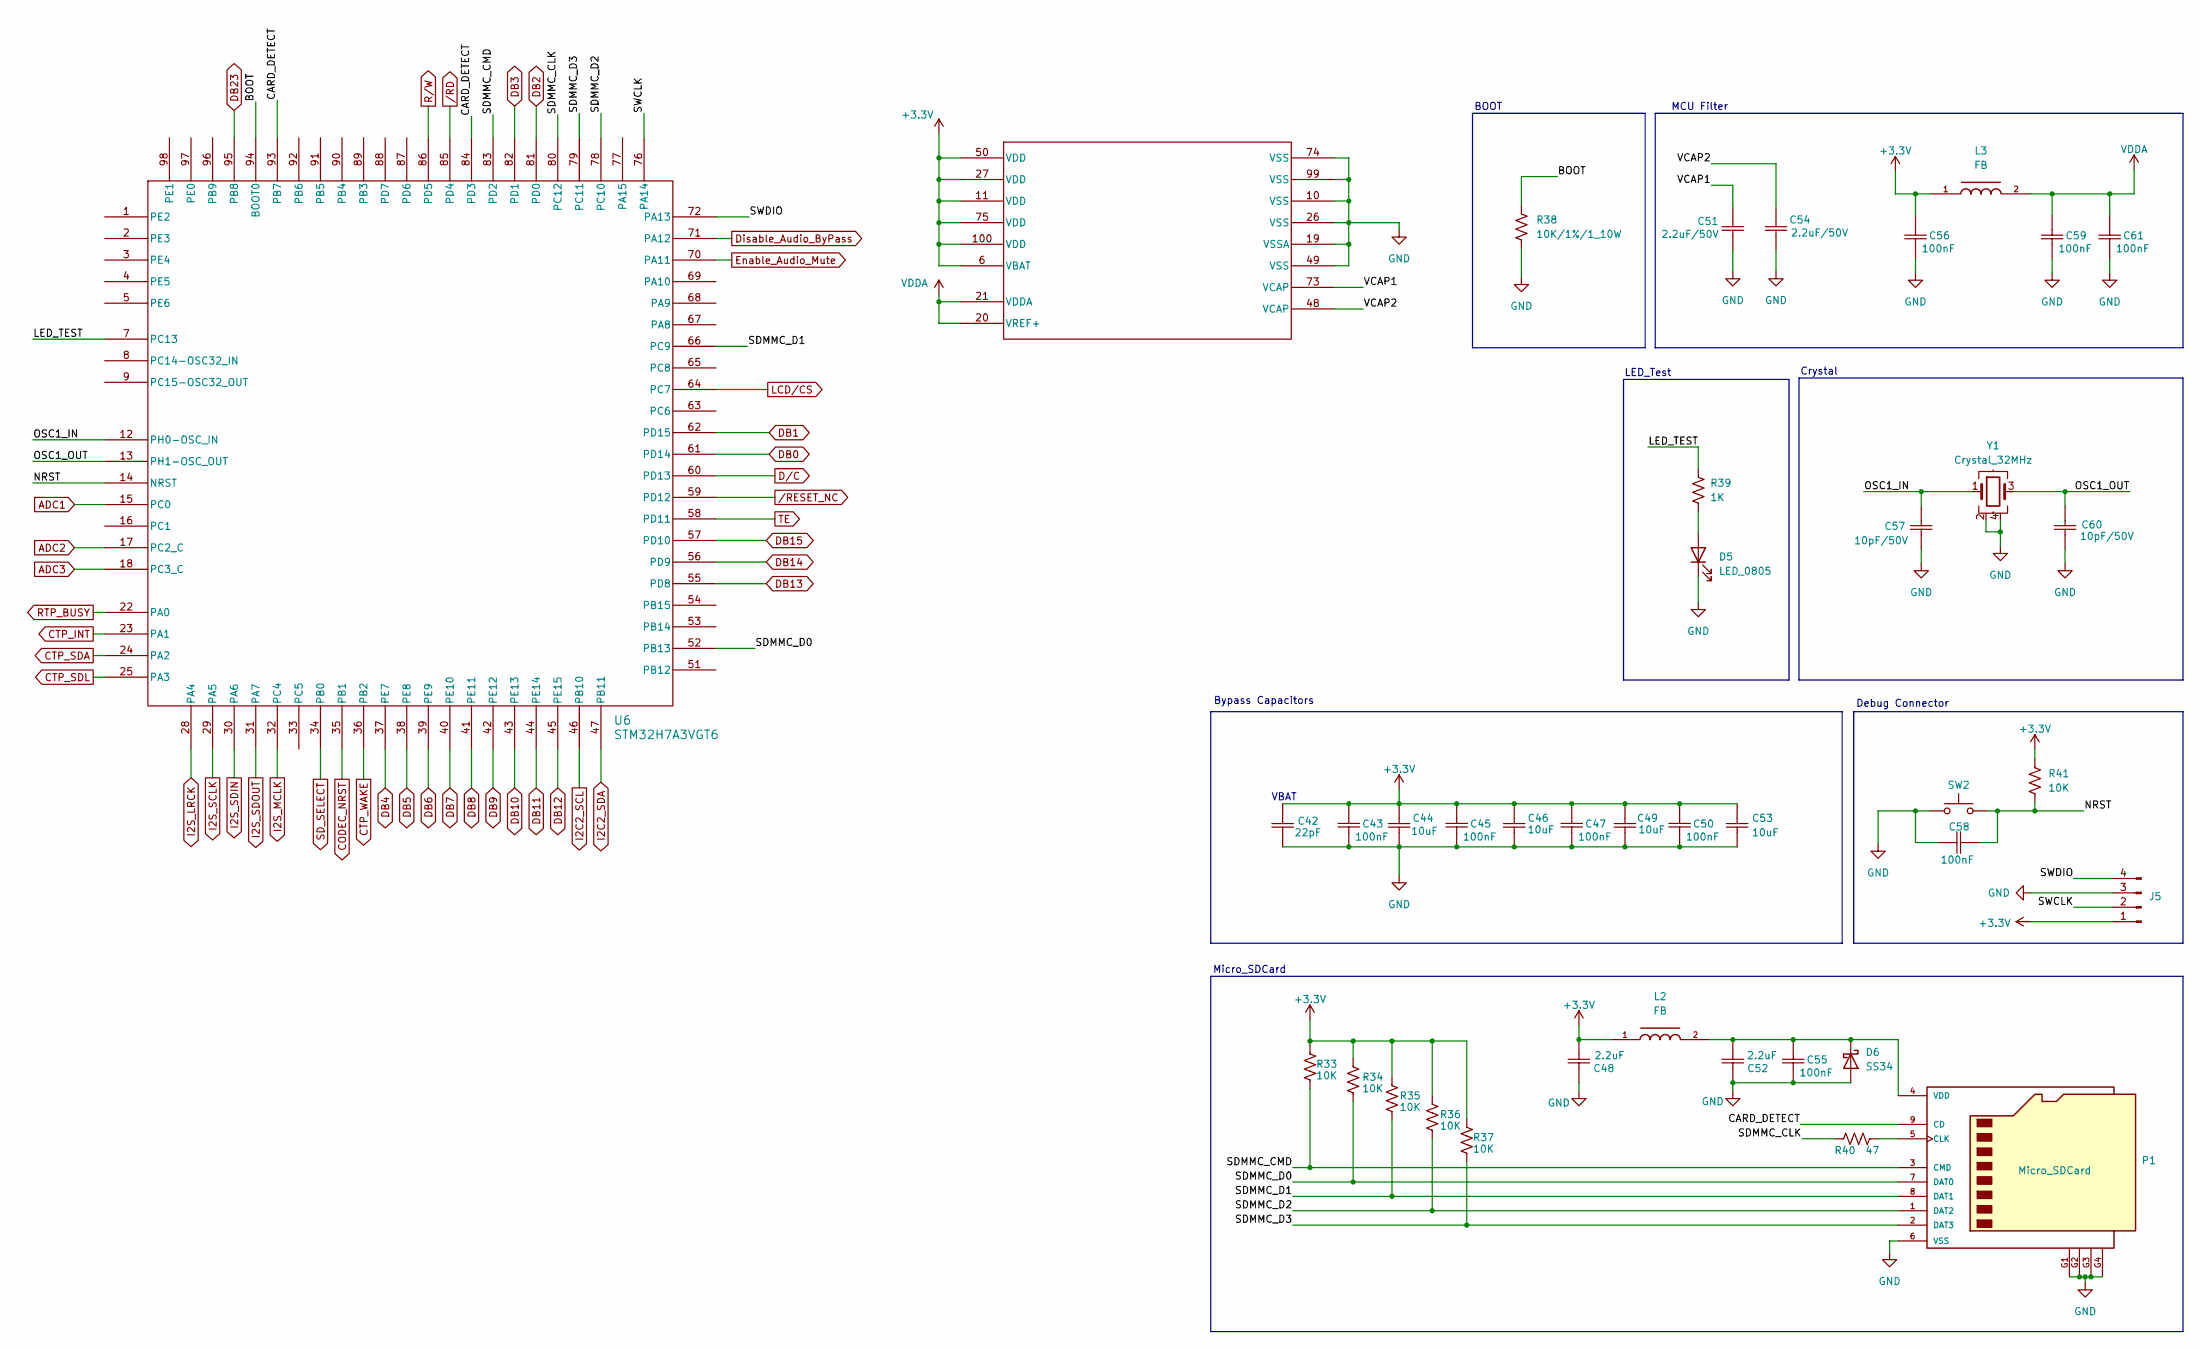
[picture p29: schematic MCU.kicad_sch]

Parts:
C42: 22pF; Ceramic_Cap_0603
C43, C45, C47, C50, C55, C56, C58, C59, C61: 100nF; Ceramic_Cap_0603
C44, C46, C49, C53: 10uF; Ceramic_Cap_0603
C48, C52: 2.2uF; Ceramic_Cap_0603
C51, C54: 2.2uF/50V; Ceramic_Cap_0603
C57, C60: 10pF/50V; Ceramic_Cap_0603
D5: LED_0805
D6: SS34; D_SMA
J5: PinHeader_1x04_P2.54mm_Horizontal
L2, L3: FB; FB_0805
P1: Micro_SDCard; SD_Card
R33, R34, R35, R36, R37, R41: 10K; Res_0603
R38: 10K/1%/1_10W; Res_0603
R39: 1K; Res_0603
R40: 47; Res_0402
SW2: SW_SMD
U6: STM32H7A3VGT6; STM32
Y1: Crystal_32MHz; XTAL_TSX-3225_16.0000MF18X-AC3

Connections:
+3.3V: C42.2, C43.1, C44.2, C45.1, C46.2, C47.1, C48.1, C49.2, C50.1, C53.2, C56.1, J5.1, L2.1, L3.1, R33.2, R34.2, R35.2, R36.2, R37.2, R41.2, U6.6 (VBAT), U6.11 (VDD), U6.27 (VDD), U6.50 (VDD), U6.75 (VDD), U6.100 (VDD); also elsewhere on the board
/MCU/BOOT: R38.2, U6.94 (BOOT0)
/MCU/CARD_DETECT: P1.9 (CD), U6.84 (PD3), U6.93 (PB7)
/MCU/LED_TEST: R39.1, U6.7 (PC13)
/MCU/NRST: C58.1, R41.1, SW2.2, U6.14 (NRST)
/MCU/OSC1_IN: C57.1, U6.12 (PH0-OSC_IN), Y1.1
/MCU/OSC1_OUT: C60.1, U6.13 (PH1-OSC_OUT), Y1.3
/MCU/SDMMC_CLK: R40.1, U6.80 (PC12)
/MCU/SDMMC_CMD: P1.3 (CMD), R33.1, U6.83 (PD2)
/MCU/SDMMC_D0: P1.7 (DAT0), R34.1, U6.52 (PB13)
/MCU/SDMMC_D1: P1.8 (DAT1), R35.1, U6.66 (PC9)
/MCU/SDMMC_D2: P1.1 (DAT2), R36.1, U6.78 (PC10)
/MCU/SDMMC_D3: P1.2 (DAT3), R37.1, U6.79 (PC11)
/MCU/SWCLK: J5.2, U6.76 (PA14)
/MCU/SWDIO: J5.4, U6.72 (PA13)
/MCU/VCAP1: C51.2, U6.73 (VCAP)
/MCU/VCAP2: C54.2, U6.48 (VCAP)
ADC1: U6.15 (PC0); also elsewhere on the board
ADC2: U6.17 (PC2_C); also elsewhere on the board
ADC3: U6.18 (PC3_C); also elsewhere on the board
CODEC_NRST: U6.35 (PB1); also elsewhere on the board
CTP_INT: U6.23 (PA1); also elsewhere on the board
CTP_SDA: U6.24 (PA2); also elsewhere on the board
CTP_SDL: U6.25 (PA3); also elsewhere on the board
CTP_WAKE: U6.36 (PB2); also elsewhere on the board
DB0: U6.61 (PD14); also elsewhere on the board
DB1: U6.62 (PD15); also elsewhere on the board
DB2: U6.81 (PD0); also elsewhere on the board
DB3: U6.82 (PD1); also elsewhere on the board
DB4: U6.37 (PE7); also elsewhere on the board
DB5: U6.38 (PE8); also elsewhere on the board
DB6: U6.39 (PE9); also elsewhere on the board
DB7: U6.40 (PE10); also elsewhere on the board
DB8: U6.41 (PE11); also elsewhere on the board
DB9: U6.42 (PE12); also elsewhere on the board
DB10: U6.43 (PE13); also elsewhere on the board
DB11: U6.44 (PE14); also elsewhere on the board
DB12: U6.45 (PE15); also elsewhere on the board
DB13: U6.55 (PD8); also elsewhere on the board
DB14: U6.56 (PD9); also elsewhere on the board
DB15: U6.57 (PD10); also elsewhere on the board
DB23: U6.95 (PB8)
Disable_Audio_ByPass: U6.71 (PA12)
D/C: U6.60 (PD13); also elsewhere on the board
Enable_Audio_Mute: U6.70 (PA11)
GND: C42.1, C43.2, C44.1, C45.2, C46.1, C47.2, C48.2, C49.1, C50.2, C51.1, C52.2, C53.1, C54.1, C55.2, C56.2, C57.2, C58.2, C59.2, C60.2, C61.2, D5.1 (K), D6.2 (A), J5.3, P1.6 (VSS), P1.G1, P1.G2, P1.G3, P1.G4, R38.1, SW2.1, U6.10 (VSS), U6.19 (VSSA), U6.26 (VSS), U6.49 (VSS), U6.74 (VSS), U6.99 (VSS), Y1.2, Y1.4; also elsewhere on the board
I2C2_SCL: U6.46 (PB10); also elsewhere on the board
I2C2_SDA: U6.47 (PB11); also elsewhere on the board
I2S_LRCK: U6.28 (PA4); also elsewhere on the board
I2S_MCLK: U6.32 (PC4); also elsewhere on the board
I2S_SCLK: U6.29 (PA5); also elsewhere on the board
I2S_SDIN: U6.30 (PA6); also elsewhere on the board
I2S_SDOUT: U6.31 (PA7); also elsewhere on the board
LCD/CS: U6.64 (PC7); also elsewhere on the board
unnamed: D5.2 (A), R39.2
unnamed: C52.1, C55.1, D6.1 (K), L2.2, P1.4 (VDD)
unnamed: P1.5 (CLK), R40.2
RTP_BUSY: U6.22 (PA0); also elsewhere on the board
R/W: U6.86 (PD5); also elsewhere on the board
SD_SELECT: U6.34 (PB0); also elsewhere on the board
TE: U6.58 (PD11); also elsewhere on the board
VDDA: C59.1, C61.1, L3.2, U6.20 (VREF+), U6.21 (VDDA)
/RD: U6.85 (PD4); also elsewhere on the board
/RESET_NC: U6.59 (PD12); also elsewhere on the board

Notes on the sheet:
BOOT
Crystal
Debug Connector
LED_Test
VBAT
Bypass Capacitors
Micro_SDCard
MCU Filter

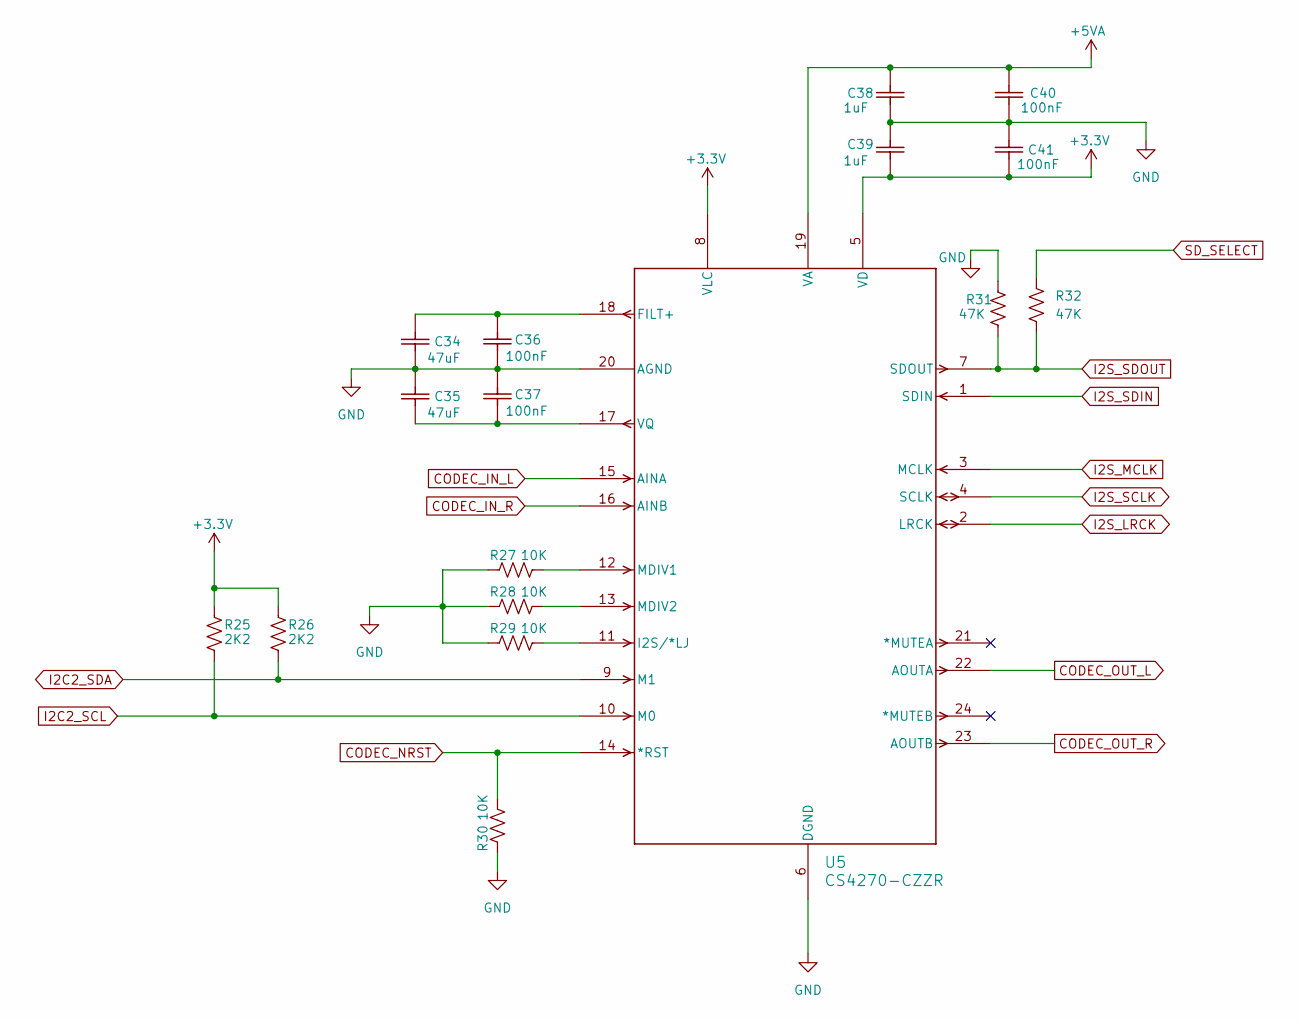
[picture p30: schematic Codec.kicad_sch]

Parts:
C34, C35: 47uF; Ceramic_Cap_0805
C36, C37, C40, C41: 100nF; Ceramic_Cap_0603
C38, C39: 1uF; Ceramic_Cap_0603
R25, R26: 2K2; Res_0603
R27, R28, R29, R30: 10K; Res_0603
R31, R32: 47K; Res_0603
U5: CS4270-CZZR; CIR-TSSOP-24

Connections:
+3.3V: C39.2, C41.2, R25.2, R26.2, U5.5 (VD), U5.8 (VLC); also elsewhere on the board
+5VA: C38.1, C40.1, U5.19 (VA); also elsewhere on the board
CODEC_IN_L: U5.15 (AINA); also elsewhere on the board
CODEC_IN_R: U5.16 (AINB); also elsewhere on the board
CODEC_NRST: R30.2, U5.14 (*RST); also elsewhere on the board
CODEC_OUT_L: U5.22 (AOUTA); also elsewhere on the board
CODEC_OUT_R: U5.23 (AOUTB); also elsewhere on the board
GND: C34.1, C35.2, C36.2, C37.1, C38.2, C39.1, C40.2, C41.1, R27.1, R28.1, R29.1, R30.1, R31.2, U5.6 (DGND), U5.20 (AGND); also elsewhere on the board
I2C2_SCL: R25.1, U5.10 (M0); also elsewhere on the board
I2C2_SDA: R26.1, U5.9 (M1); also elsewhere on the board
I2S_LRCK: U5.2 (LRCK); also elsewhere on the board
I2S_MCLK: U5.3 (MCLK); also elsewhere on the board
I2S_SCLK: U5.4 (SCLK); also elsewhere on the board
I2S_SDIN: U5.1 (SDIN); also elsewhere on the board
I2S_SDOUT: R31.1, R32.1, U5.7 (SDOUT); also elsewhere on the board
unnamed: C34.2, C36.1, U5.18 (FILT+)
unnamed: R29.2, U5.11 (I2S/*LJ)
unnamed: R27.2, U5.12 (MDIV1)
unnamed: R28.2, U5.13 (MDIV2)
unnamed: C35.1, C37.2, U5.17 (VQ)
SD_SELECT: R32.2; also elsewhere on the board

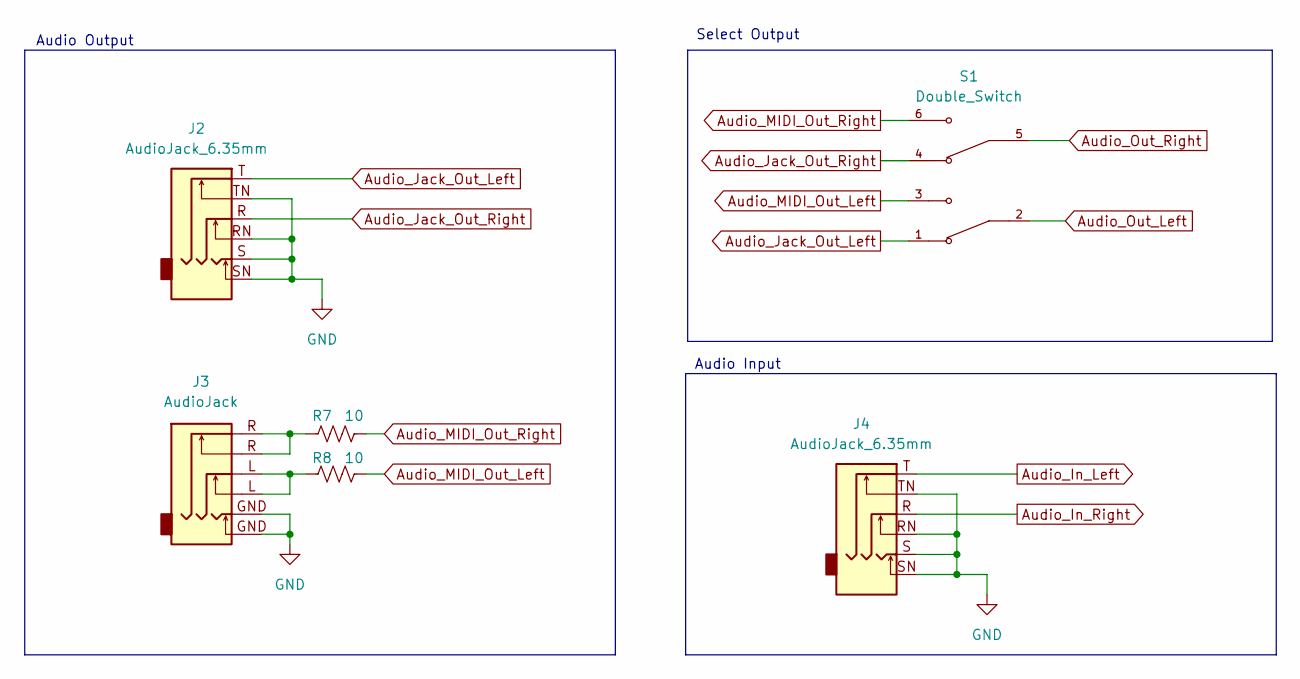
[picture p31: schematic Input_Output.kicad_sch]

Parts:
J2, J4: AudioJack_6.35mm; Jack_Audio_6.35mm
J3: AudioJack; Audio_connector
R7, R8: 10; Res_0603
S1: Double_Switch; PARTREV C

Connections:
Audio_In_Left: J4.T; also elsewhere on the board
Audio_In_Right: J4.R; also elsewhere on the board
Audio_Jack_Out_Left: J2.T, S1.1
Audio_Jack_Out_Right: J2.R, S1.4
Audio_MIDI_Out_Left: R8.2, S1.3
Audio_MIDI_Out_Right: R7.2, S1.6
Audio_Out_Left: S1.2; also elsewhere on the board
Audio_Out_Right: S1.5; also elsewhere on the board
GND: J2.RN, J2.S, J2.SN, J2.TN, J3.GND, J4.RN, J4.S, J4.SN, J4.TN; also elsewhere on the board
unnamed: J3.L, R8.1
unnamed: J3.R, R7.1

Notes on the sheet:
Audio Output
Select Output
Audio Input

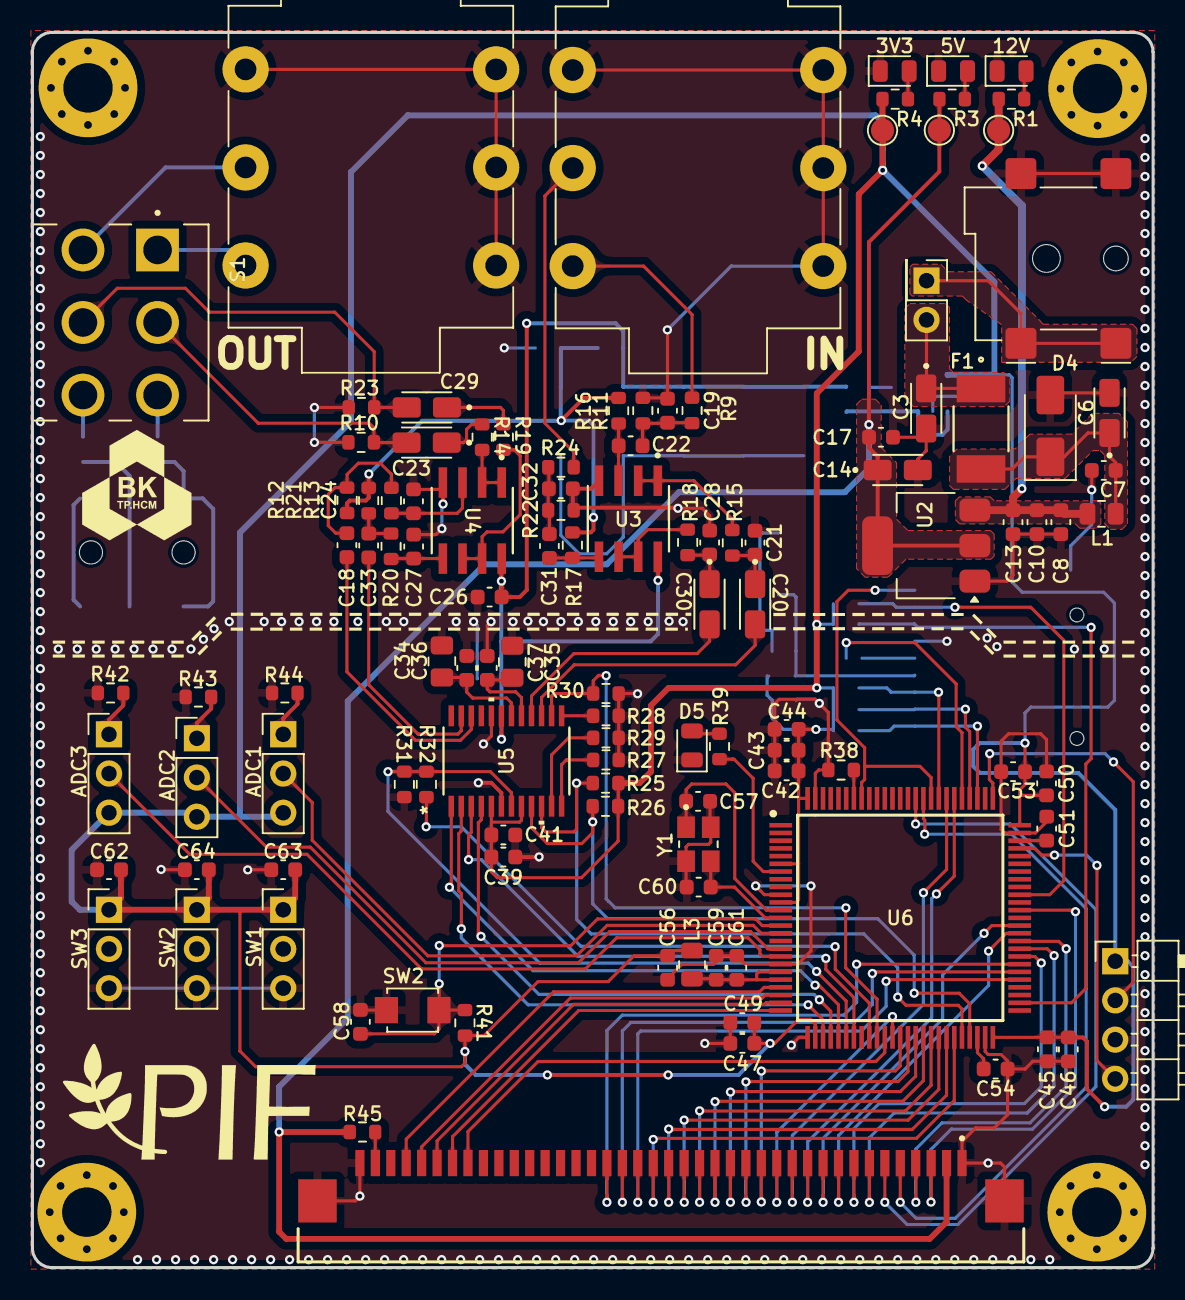
[picture p32: board Digital_Multi_Pedal_v1.kicad_pcb from above]

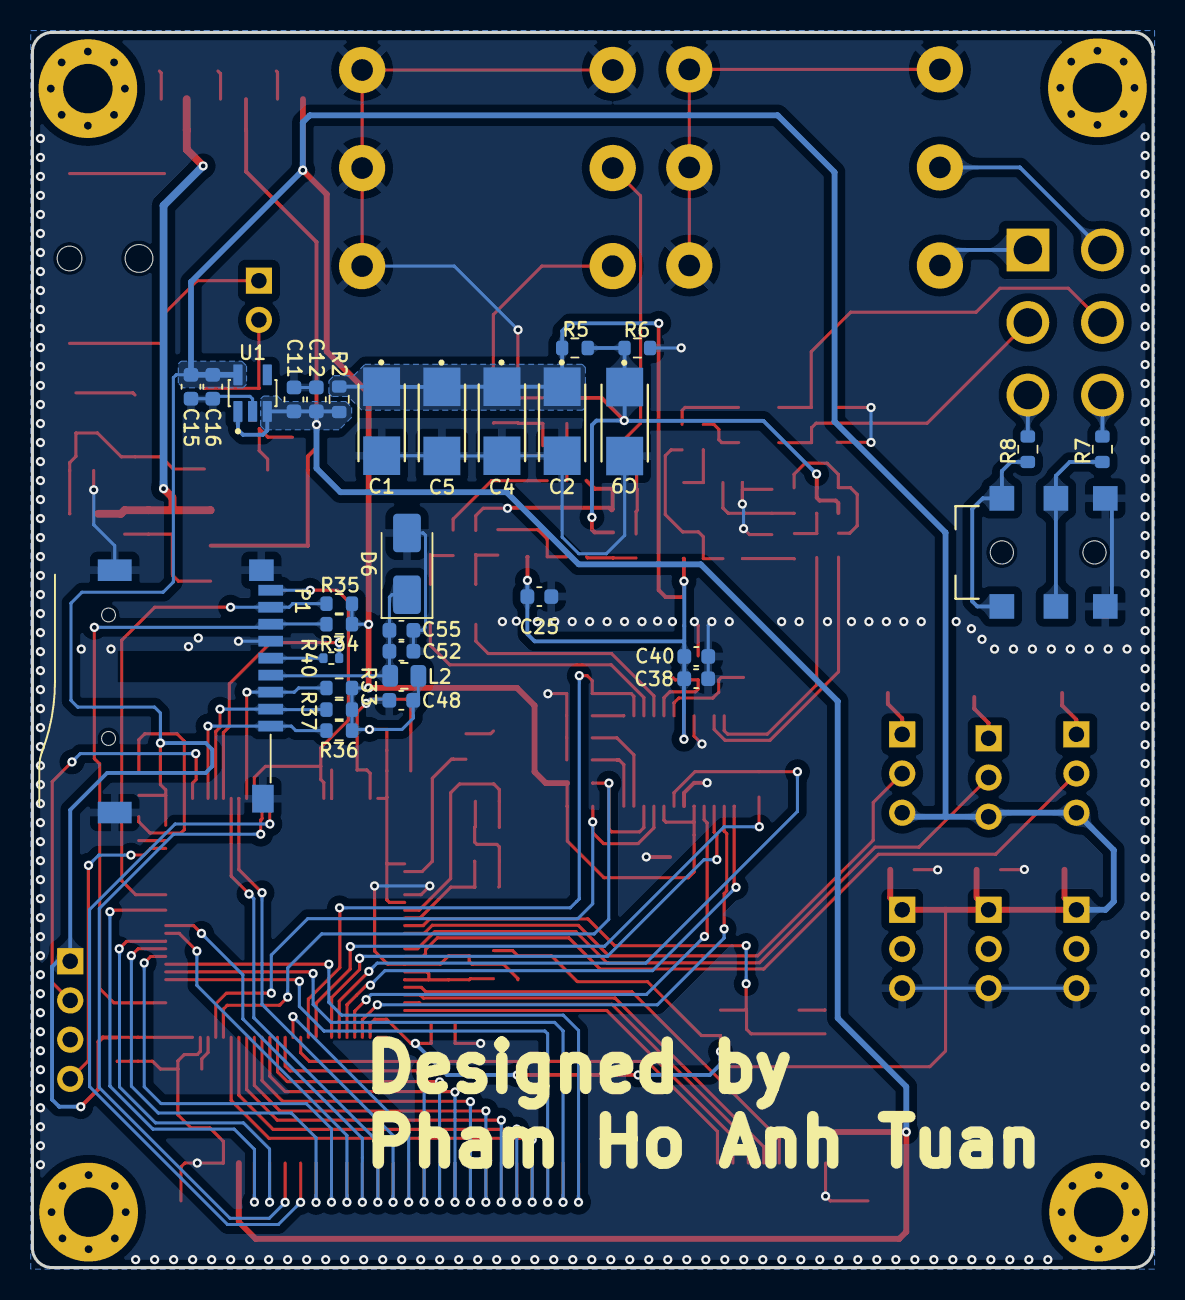
[picture p33: board Digital_Multi_Pedal_v1.kicad_pcb from below]

Board: 4 copper layers, 72.6 x 80.0 mm, 149 parts (31 on the bottom side), 110 nets.

Other parts of the board:
ADC1, ADC2, ADC3: VariableRes; PinHeader_1x03_P2.54mm_Vertical
C62, C63, C64: 10uF; Ceramic_Cap_0603
J9: Connector_40pin
R42, R43, R44, R45: 100R; Res_0603
SW1#2, SW2#2, SW3: Footswitch; PinHeader_1x03_P2.54mm_Vertical

Their connections:
+3.3V: ADC1.3, ADC2.3, ADC3.3, C62.2, C63.2, C64.2, SW1#2.1 (A), SW2#2.1 (A), SW3.1 (A); also elsewhere on the board
+5V: J9.2, R45.2; also elsewhere on the board
ADC1: ADC1.2; also elsewhere on the board
ADC2: ADC2.2; also elsewhere on the board
ADC3: ADC3.2; also elsewhere on the board
CTP_INT: J9.36; also elsewhere on the board
CTP_SDA: J9.35; also elsewhere on the board
CTP_SDL: J9.34; also elsewhere on the board
CTP_WAKE: J9.33; also elsewhere on the board
DB0: J9.9; also elsewhere on the board
DB1: J9.10; also elsewhere on the board
DB2: J9.11; also elsewhere on the board
DB3: J9.12; also elsewhere on the board
DB4: J9.13; also elsewhere on the board
DB5: J9.14; also elsewhere on the board
DB6: J9.15; also elsewhere on the board
DB7: J9.16; also elsewhere on the board
DB8: J9.17; also elsewhere on the board
DB9: J9.18; also elsewhere on the board
DB10: J9.19; also elsewhere on the board
DB11: J9.20; also elsewhere on the board
DB12: J9.21; also elsewhere on the board
DB13: J9.22; also elsewhere on the board
DB14: J9.23; also elsewhere on the board
DB15: J9.24; also elsewhere on the board
D/C: J9.4; also elsewhere on the board
GND: C62.1, C63.1, C64.1, J9.1, J9.40, J9.S1 (SHIELD), J9.S2 (SHIELD), R42.1, R43.1, R44.1, SW1#2.3 (C), SW2#2.3 (C), SW3.3 (C); also elsewhere on the board
LCD/CS: J9.3; also elsewhere on the board
unnamed: J9.39, R45.1
unnamed: ADC3.1, R42.2
unnamed: ADC2.1, R43.2
unnamed: ADC1.1, R44.2
RTP_BUSY: J9.37; also elsewhere on the board
R/W: J9.6; also elsewhere on the board
TE: J9.8; also elsewhere on the board
/RD: J9.5; also elsewhere on the board
/RESET_NC: J9.7; also elsewhere on the board
