TransistorTun/Tuna_Pedal/Firmware/Ref/F412_FSMC_LCD/Core/Src/main.c

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
/* Includes ------------------------------------------------------------------*/
#include "main.h"

/* USER CODE BEGIN Includes */
#include "st7789h2.h"
#include "ft6x06.h"
/* USER CODE END Includes */

I2C_HandleTypeDef hi2c1;

SRAM_HandleTypeDef hsram1;

void SystemClock_Config(void);
static void MX_GPIO_Init(void);
static void MX_FSMC_Init(void);
static void MX_I2C1_Init(void);
/* USER CODE BEGIN 0 */

void LCD_Fill(uint16_t RGBCode, uint16_t Xpos, uint16_t Ypos, uint16_t width, uint16_t height)
{
	for (uint16_t i=0; i<height; i++)
	{
		ST7789H2_DrawHLine(RGBCode, Xpos, Ypos++, width);
	}
}

uint16_t RAW_X, RAW_Y;
/* USER CODE END 0 */

/**
  * @brief  The application entry point.
  * @retval int
  */
int main(void)
{

  /* MCU Configuration--------------------------------------------------------*/

  /* Reset of all peripherals, Initializes the Flash interface and the Systick. */
  HAL_Init();

  /* Configure the system clock */
  SystemClock_Config();

  /* Initialize all configured peripherals */
  MX_GPIO_Init();
  MX_FSMC_Init();
  MX_I2C1_Init();
  /* USER CODE BEGIN 2 */

  ST7789H2_Init();
  LCD_Fill(0xF800, 0, 0, 240, 240);
  ft6x06_Init(0x70);  // 0x38>>1 = 0x70
  ft6x06_TS_Start(0x70);

  /* USER CODE END 2 */

  /* Infinite loop */
  /* USER CODE BEGIN WHILE */
  while (1)
  {
    /* USER CODE END WHILE */

    /* USER CODE BEGIN 3 */
//	  LCD_Fill(0xF800, 0, 0, 240, 240);
//	  HAL_Delay(1000);
//	  LCD_Fill(0x07E0, 0, 0, 240, 240);
//	  HAL_Delay(1000);
//	  LCD_Fill(0x001F, 0, 0, 240, 240);
//	  HAL_Delay(1000);
//	  LCD_Fill(0xFFE0, 0, 0, 240, 240);
//	  HAL_Delay(1000);

	  if (ft6x06_TS_DetectTouch(0x70))
	  {
		  ft6x06_TS_GetXY(0x70, &RAW_X, &RAW_Y);
	  }

	  HAL_Delay(100);
  }
  /* USER CODE END 3 */
}

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
