TransistorTun/Tuna_Pedal/Firmware/Ref/HDMI_F4/HDMI_F4.ioc

Mcu.UserName=STM32F407VGTx
PA11.Signal=USB_OTG_FS_DM
PA12.Signal=USB_OTG_FS_DP
PA13.Signal=SYS_JTMS-SWDIO
PA14.Signal=SYS_JTCK-SWCLK
PA15.GPIO_Label=SD_CS
PA15.Signal=GPIO_Output
PA2.Signal=USART2_TX
PA3.Signal=USART2_RX
PA4.GPIO_Label=ROM_CS
PA4.Signal=GPIO_Output
PA5.Signal=SPI1_SCK
PA6.Signal=SPI1_MISO
PA7.Signal=SPI1_MOSI
PB0.GPIO_Label=CTP_RST
PB0.Signal=GPIO_Output
PB1.GPIO_Label=CTP_INT
PB1.Signal=GPIO_Output
PB7.Signal=I2C1_SDA
PB8.Signal=I2C1_SCL
PB9.GPIO_Label=LED
PB9.Signal=GPIO_Output
PC10.Signal=SPI3_SCK
PC11.Signal=SPI3_MISO
PC12.Signal=SPI3_MOSI
PC7.Signal=GPIO_Output
PC8.GPIO_Label=SD_DETECT 
PC8.Signal=GPIO_Input
PD0.Signal=FSMC_D2
PD1.Signal=FSMC_D3
PD10.Signal=FSMC_D15
PD11.Signal=FSMC_A16
PD14.Signal=FSMC_D0
PD15.Signal=FSMC_D1
PD4.Signal=FSMC_NOE
PD5.Signal=FSMC_NWE
PD6.GPIO_Label=TFT_RESET
PD6.Signal=GPIO_Output
PD7.Signal=FSMC_NE1
PD8.Signal=FSMC_D13
PD9.Signal=FSMC_D14
PE0.GPIO_Label=POWER_SW
PE0.Signal=GPIO_Input
PE1.GPIO_Label=POWER_ON
PE1.Signal=GPIO_Output
PE10.Signal=FSMC_D7
PE11.Signal=FSMC_D8
PE12.Signal=FSMC_D9
PE13.Signal=FSMC_D10
PE14.Signal=FSMC_D11
PE15.Signal=FSMC_D12
PE7.Signal=FSMC_D4
PE8.Signal=FSMC_D5
PE9.Signal=FSMC_D6
PH0-OSC_IN.Signal=RCC_OSC_IN
PH1-OSC_OUT.Signal=RCC_OSC_OUT
