TransistorTun/Tuna_Pedal/Firmware/Ref/HDMI_F4/Core/Inc/main.h

#define ROM_CS_Pin GPIO_PIN_4
#define ROM_CS_GPIO_Port GPIOA
#define CTP_RST_Pin GPIO_PIN_0
#define CTP_RST_GPIO_Port GPIOB
#define CTP_INT_Pin GPIO_PIN_1
#define CTP_INT_GPIO_Port GPIOB
#define SD_DETECT_Pin GPIO_PIN_8
#define SD_DETECT_GPIO_Port GPIOC
#define SD_CS_Pin GPIO_PIN_15
#define SD_CS_GPIO_Port GPIOA
#define TFT_RESET_Pin GPIO_PIN_6
#define TFT_RESET_GPIO_Port GPIOD
#define LED_Pin GPIO_PIN_9
#define LED_GPIO_Port GPIOB
#define POWER_SW_Pin GPIO_PIN_0
#define POWER_SW_GPIO_Port GPIOE
#define POWER_ON_Pin GPIO_PIN_1
#define POWER_ON_GPIO_Port GPIOE
