TransistorTun/Tuna_Pedal/Firmware/Ref/F412_FSMC_LCD/Core/Inc/LCD_Touch.h

/*
 * LCD_Touch.h
 *
 *  Created on: Apr 9, 2024
 *      Author: arunrawat
 */

#ifndef INC_LCD_TOUCH_H_
#define INC_LCD_TOUCH_H_

#include "main.h"

 void     TS_IO_Init(void);
 void     TS_IO_Write(uint8_t Addr, uint8_t Reg, uint8_t Value);
 uint8_t  TS_IO_Read(uint8_t Addr, uint8_t Reg);
 uint16_t TS_IO_ReadMultiple(uint8_t Addr, uint8_t Reg, uint8_t *Buffer, uint16_t Length);
 void     TS_IO_Delay(uint32_t Delay);

#endif /* INC_LCD_TOUCH_H_ */
