TransistorTun/Tuna_Pedal/Firmware/Ref/HDMI_F4/Drivers/App/AppDrv.h

/*
 * AppDrv.h
 *
 *  Created on: Dec 23, 2024
 *      Author: thanh
 */

#ifndef APP_APPDRV_H_
#define APP_APPDRV_H_

#include "LOG.h"
#include "display_ssd1963.h"
#include "GT911.h"
#include "System.h"
#include "lvgl.h"
#include "ui.h"
#include "LCD_Controller.h"
#include "TouchController.h"
#include "UART.h"
#include "SST26VF064.h"
#include "fsp_line_task.h"
#include "Communicate.h"

#endif /* APP_APPDRV_H_ */
