TransistorTun/Tuna_Pedal/(notices)

Notices in the files:
Firmware/Ref/F412_FSMC_LCD/Core/Src/main.c:
Copyright (c) 2024 STMicroelectronics.
All rights reserved.
